Jotasquimsdb/TCC-Caua-e-Joaquim/fotos/ft2.jpeg

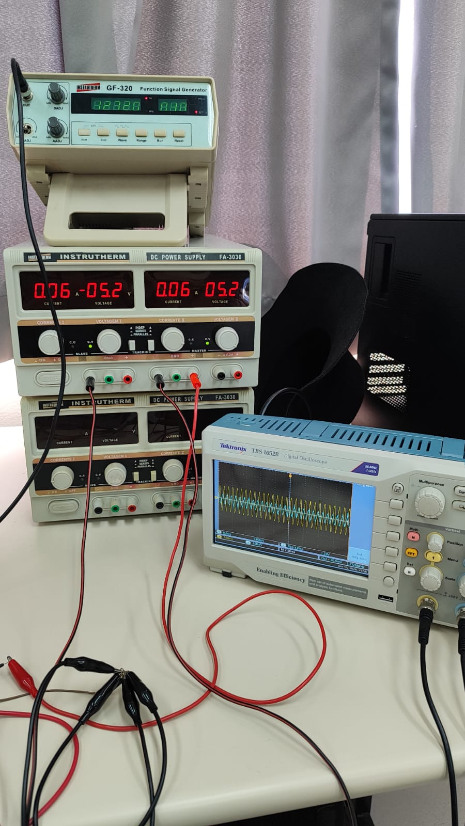
fotos/ft2.jpeg
