Jotasquimsdb/TCC-Caua-e-Joaquim/fotos/ft1.jpeg

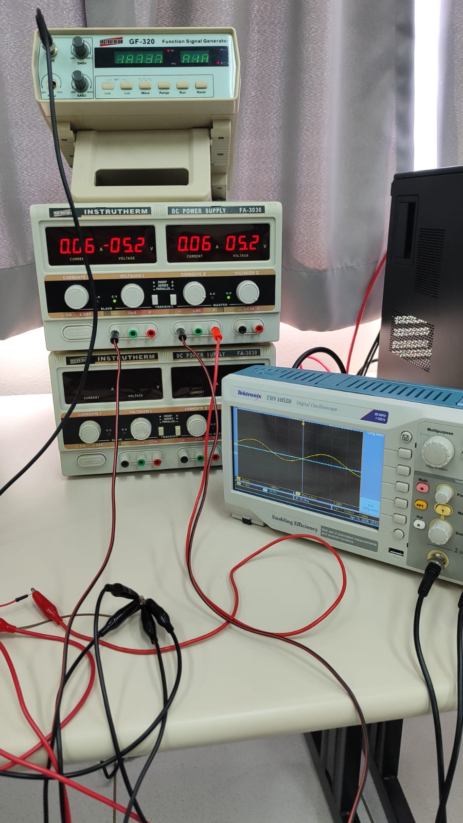
fotos/ft1.jpeg
