Jotasquimsdb/TCC-Caua-e-Joaquim/README.md

# TCC-Caua e Joaquim
 Prótese de mão Robótica Mioelétrica
