Jotasquimsdb/TCC-Caua-e-Joaquim/apresentações e banners/apresentaçãomovaci/Prótese de mão robótica mioelétrica (1).pdf

## Prótese de mão robótica

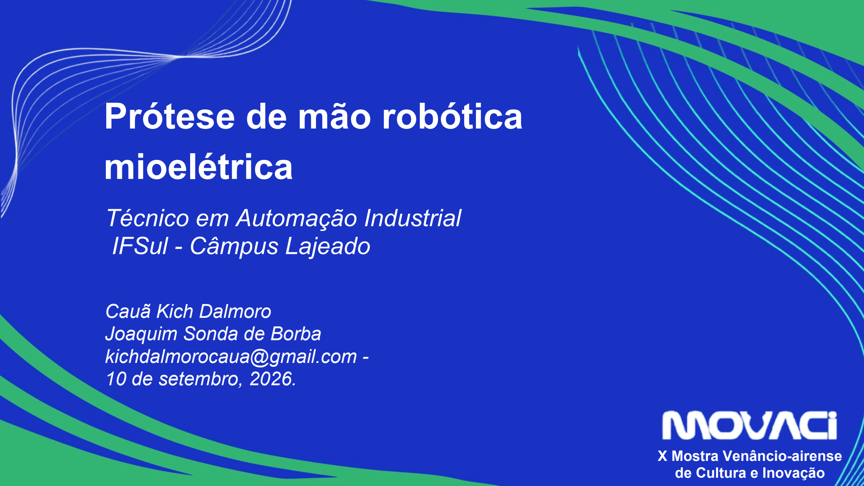
[picture p18: page 1]

## mioelétrica

Técnico em Automação Industrial IFSul - Câmpus Lajeado

Cauã Kich Dalmoro
Joaquim Sonda de Borba
kichdalmorocaua@gmail.com -10 de setembro, 2026.

X Mostra Venâncio-airense
de Cultura e Inovação

## Sumário

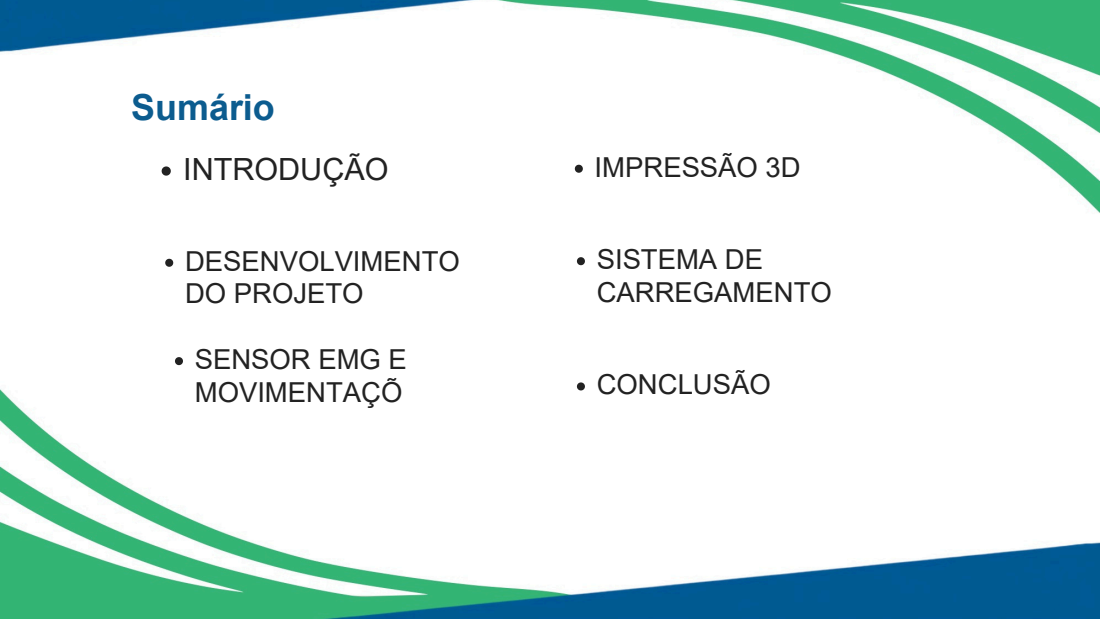
[picture p19: page 2]
DESENVOLVIMENTO DO PROJETO; INTRODUÇÃO; IMPRESSÃO 3D; SENSOR EMG E MOVIMENTAÇÕ; SISTEMA DE CARREGAMENTO; CONCLUSÃO

# INTRODUÇÃO

## Prótese de mão robótica mioelétrica O que são amputações e próteses?

Remoção cirúrgica ou
traumática de um membro ou parte do corpo proveniente de doenças vasculares,
causas traumaticas,tumores ou infecções.

Componente ou dispositivo
artificial criado para substituir uma parte ausente ou
danificada do corpo. Podem ser passivas, mecânicas,
mioelétricas, biônicas ou
recriacionais

## Prótese de mão robótica mioelétrica Justificativa e problema?

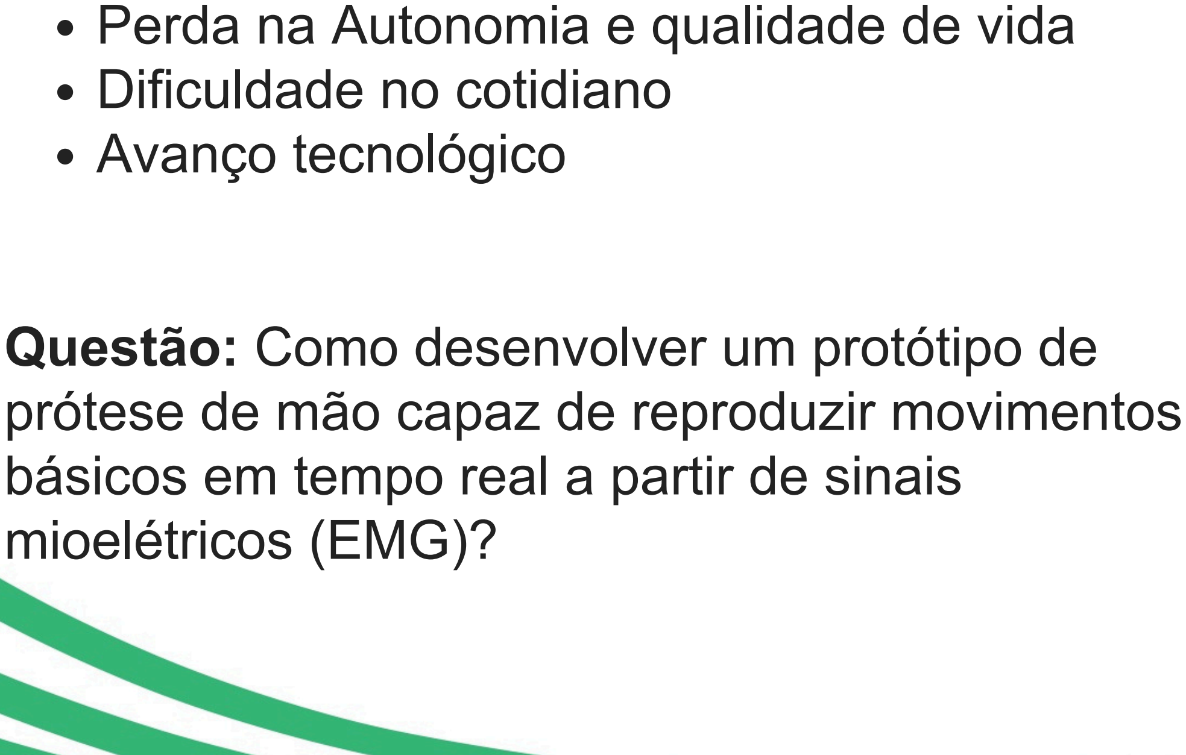
[picture p20: figure]
Perda na Autonomia e qualidade de vida Dificuldade no cotidiano Avanço tecnológico; mioelétricos (EMG)?

Questão: Como desenvolver um protótipo de prótese de mão capaz de reproduzir movimentos básicos em tempo real a partir de sinais

## Prótese de mão robótica mioelétrica Objetivos gerais e específicos

Geral: Desenvolver um protótipo de prótese de mão capaz de

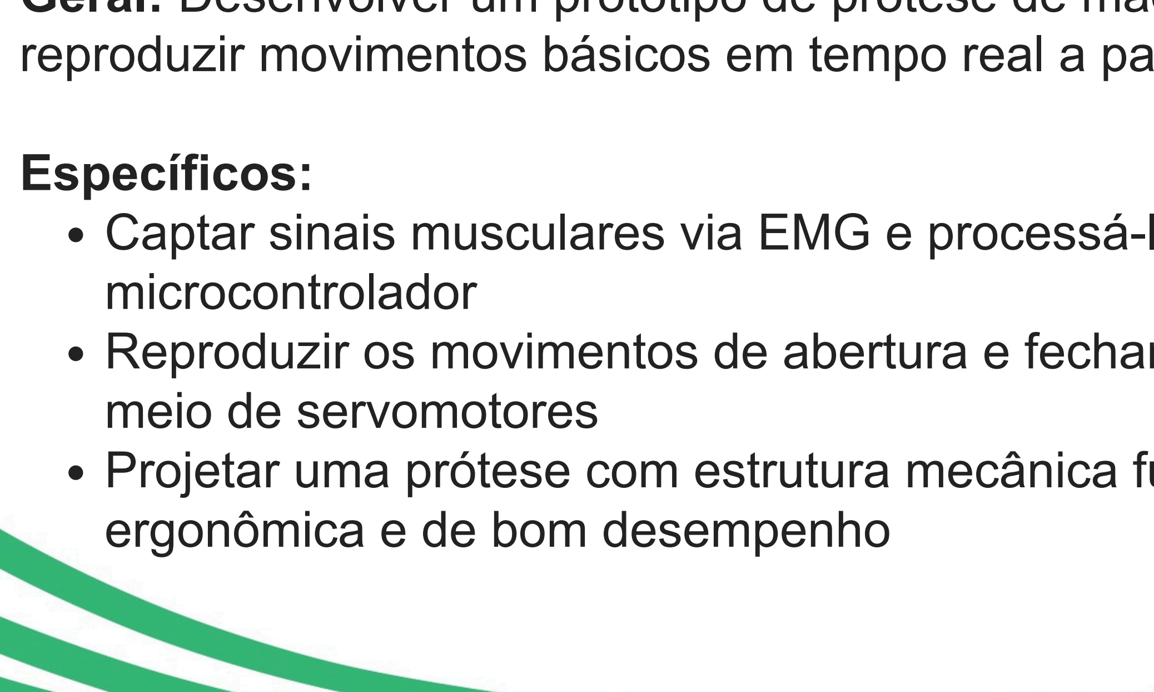
[picture p21: figure]
Específicos:; microcontrolador; meio de servomotores; ergonômica e de bom desempenho

reproduzir movimentos básicos em tempo real a partir de sinais EMG.

Captar sinais musculares via EMG e processá-los no

Reproduzir os movimentos de abertura e fechamento da mão por

Projetar uma prótese com estrutura mecânica funcional,

# DESENVOLVIMENTO DO PROJETO

### Prótese de mão robótica mioelétrica Sinais elétricos musculares

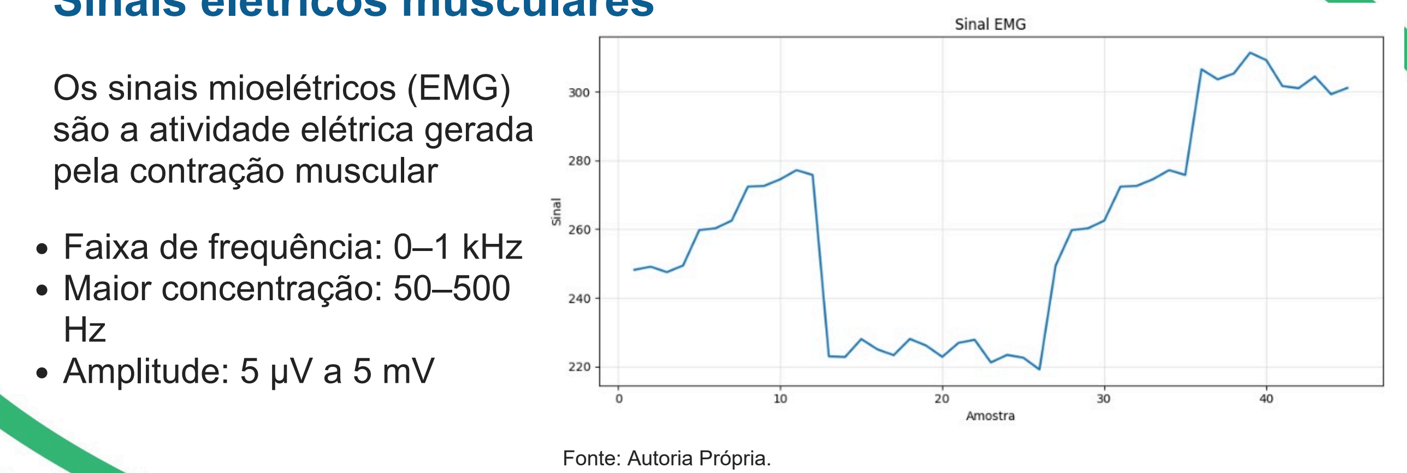
[picture p22: figure]
Os sinais mioelétricos (EMG) são a atividade elétrica gerada pela contração muscular; Fonte: Autoria Própria.; Faixa de frequência: 0–1 kHz Maior concentração: 50–500 Hz Amplitude: 5 µV a 5 mV

## Prótese de mão robótica mioelétrica Sensor invasivo x Sensor não invasivo

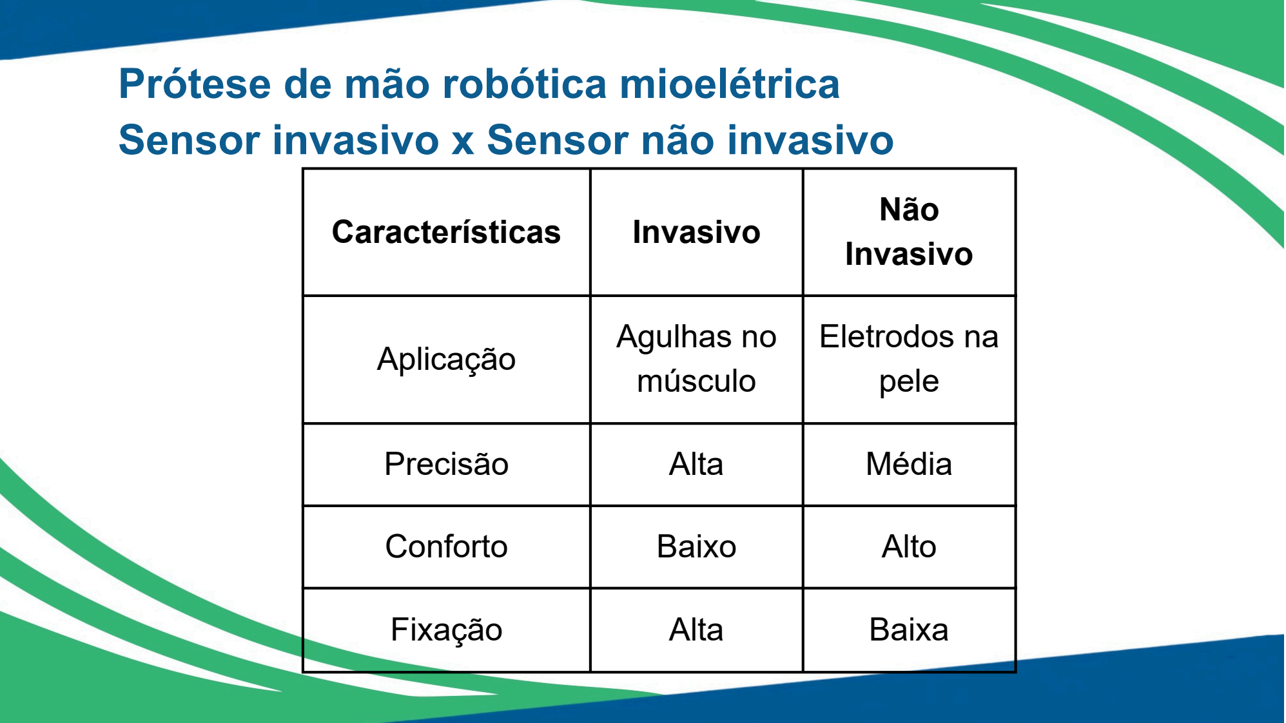
[picture p23: page 9]

Características | Invasivo | Não Invasivo
Aplicação | Agulhas no músculo | Eletrodos na pele
Precisão | Alta | Média
Conforto | Baixo | Alto
Fixação | Alta | Baixa

## Prótese de mão robótica mioelétrica Sensor invasivo x Sensor não invasivo

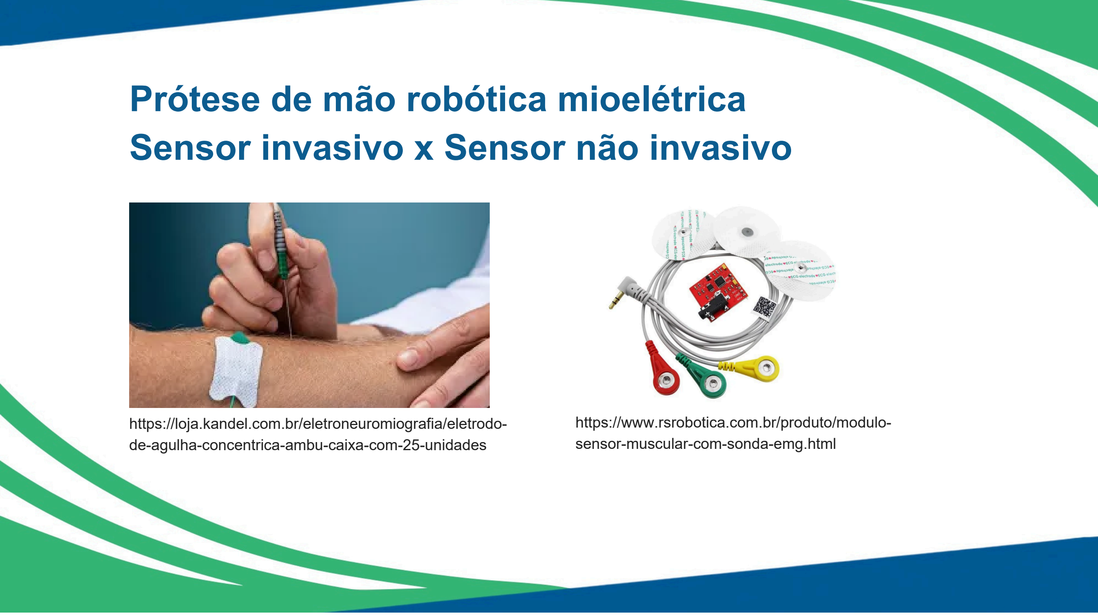
[picture p24: page 10]

https://loja.kandel.com.br/eletroneuromiografia/eletrodode-agulha-concentrica-ambu-caixa-com-25-unidadeshttps://www.rsrobotica.com.br/produto/modulosensor-muscular-c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

# SENSOR EMG E MOVIMENTAÇÃO

## Prótese de mão robótica mioelétrica Funcionamento do sensor Muscle v3

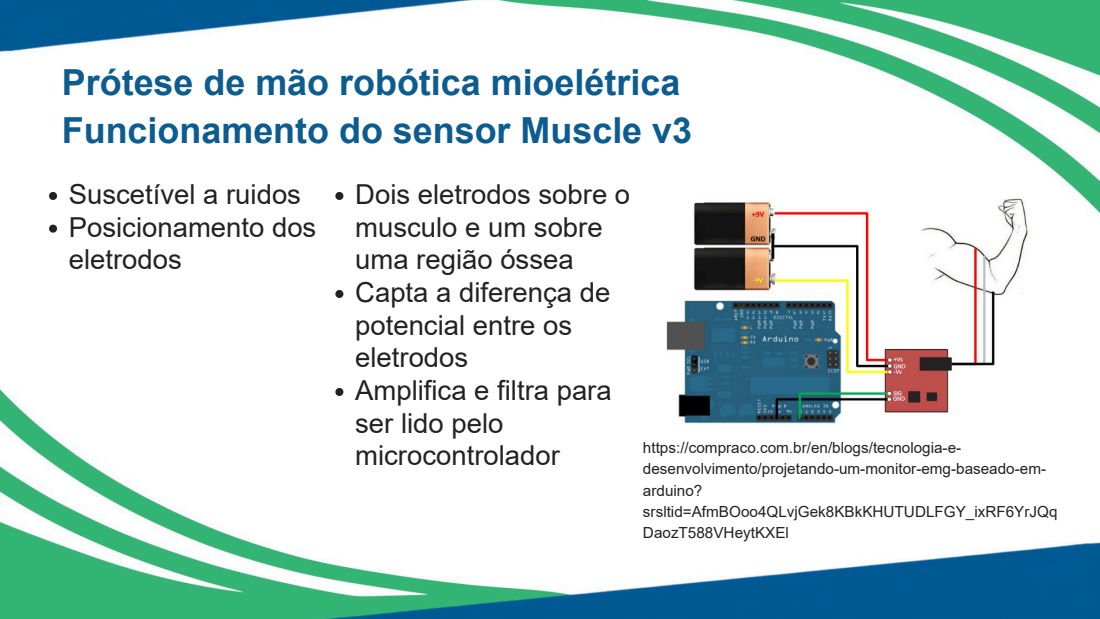
[picture p25: page 12]
microcontrolador; https://compraco.com.br/en/blogs/tecnologia-e-; Suscetível a ruidos Posicionamento dos eletrodos

Dois eletrodos sobre o
musculo e um sobre
uma região óssea
Capta a diferença de
potencial entre os
eletrodos
Amplifica e filtra para
ser lido pelo

desenvolvimento/projetando-um-monitor-emg-baseado-em-
arduino?
srsltid=AfmBOoo4QLvjGek8KBkKHUTUDLFGY_ixRF6YrJQq
DaozT588VHeytKXEl

## Prótese de mão robótica mioelétrica Funcionamento do sensor Muscle v3

Com o objetivo de melhorar a leitura do sensor, foi proposta a seguinte solução:

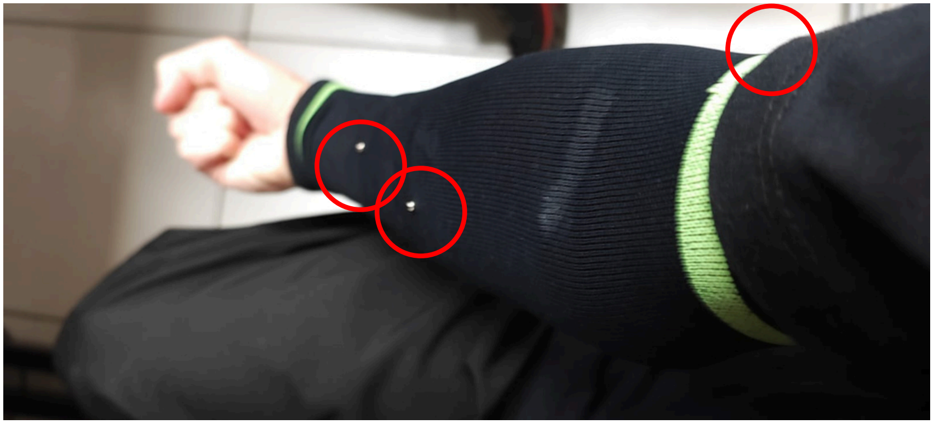
[picture p26: figure]
área para posicionar imagens

Fonte: Autoria Própria

## Prótese de mão robótica mioelétrica Código de leitura do sensor com filtragem

Utilização de uma biblioteca de filtragem
digial

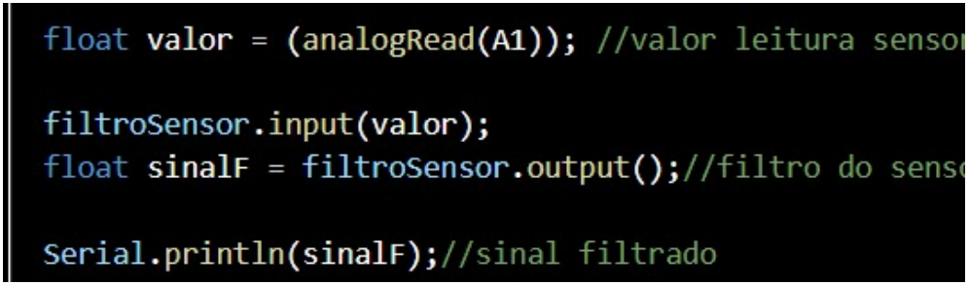
[picture p27: figure]

Fonte: Autoria Própria

Funcionamento:
Leitura do sensor
Aplicação de um filtro passabaixa
Redução de ruídos
Obtenção do sinal filtrado

## Prótese de mão robótica mioelétrica Testes de leitura do sinal

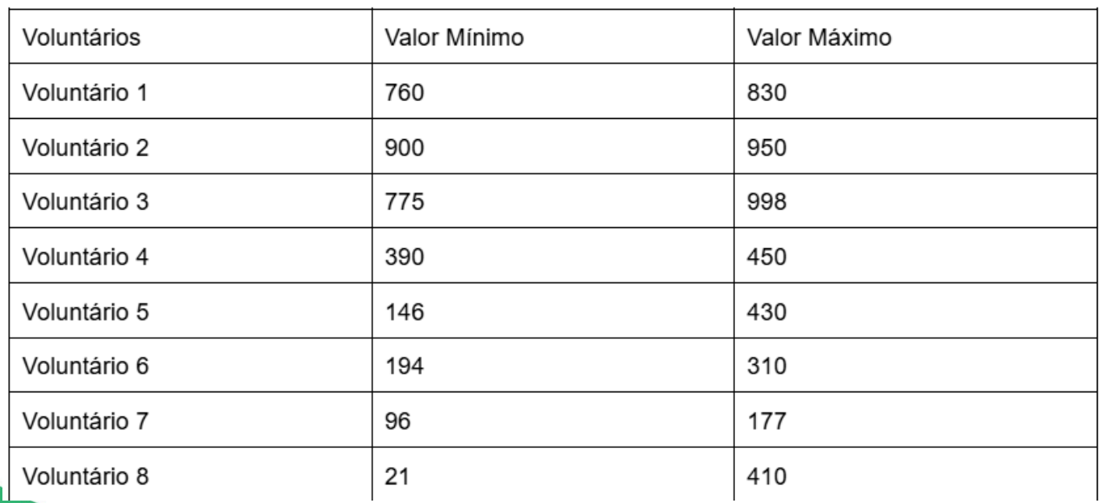
[picture p28: figure]

## Prótese de mão robótica mioelétrica Controle dos servosmotores

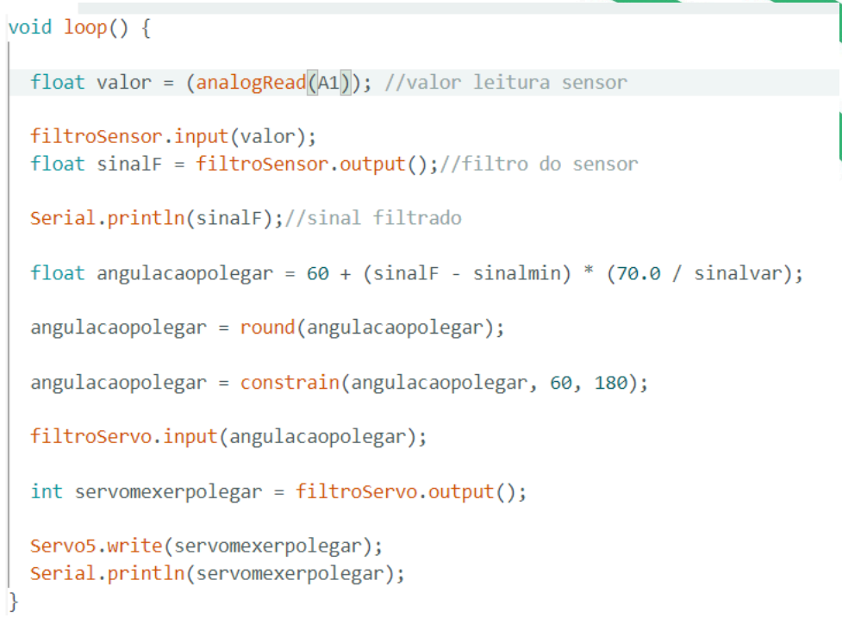
[picture p29: figure]

Fonte: Autoria Própria

Conversão do sinal EMG em
ângulo
Limitação do movimento do
servo pra cada dedo
Acionamento do servomotor
Monitoramento e calibração via Serial Plotter

## Prótese de mão robótica mioelétrica Servomotores

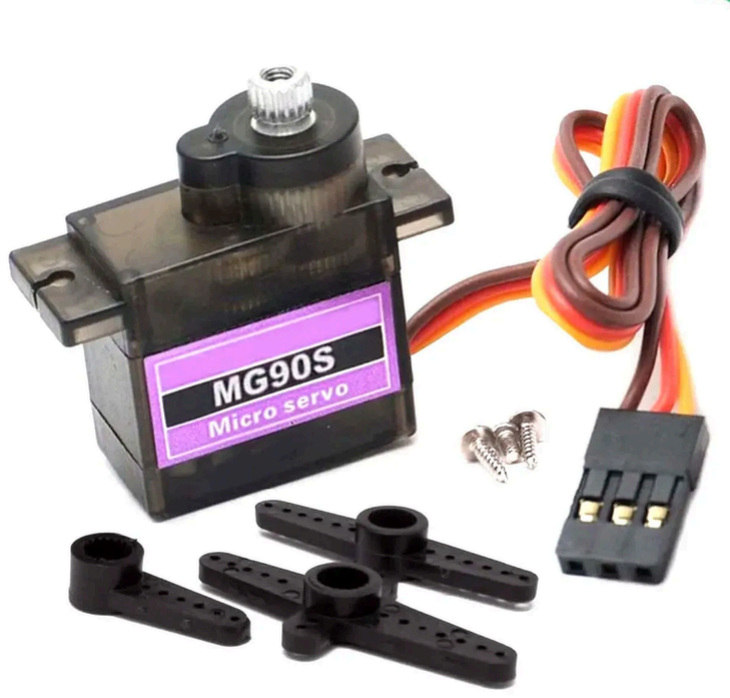
[picture p30: figure]

https://www.casadarobotica.com/robotica/atuadores/servos/microservo-motor-tower-pro-mg90s-metal-gear-com-acessorios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

Características do servomotor MG90S:
Peso: 13,4g
Tensão de operação: 5V
Torque: 1,8 kgfcm (4,8V)
Torque: 2,2 kgfcm (6V)

# IMPRESSÃO 3D

## Prótese de mão robótica mioelétrica Impressão da mão 3D

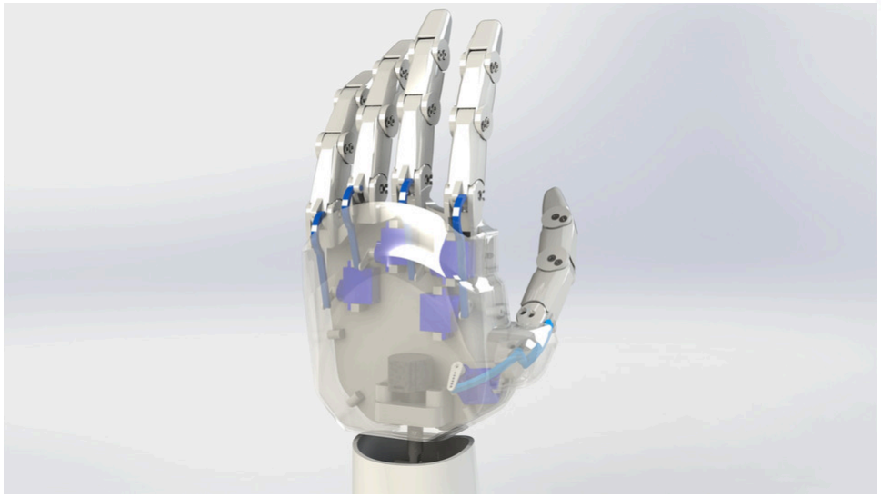
[picture p31: figure]
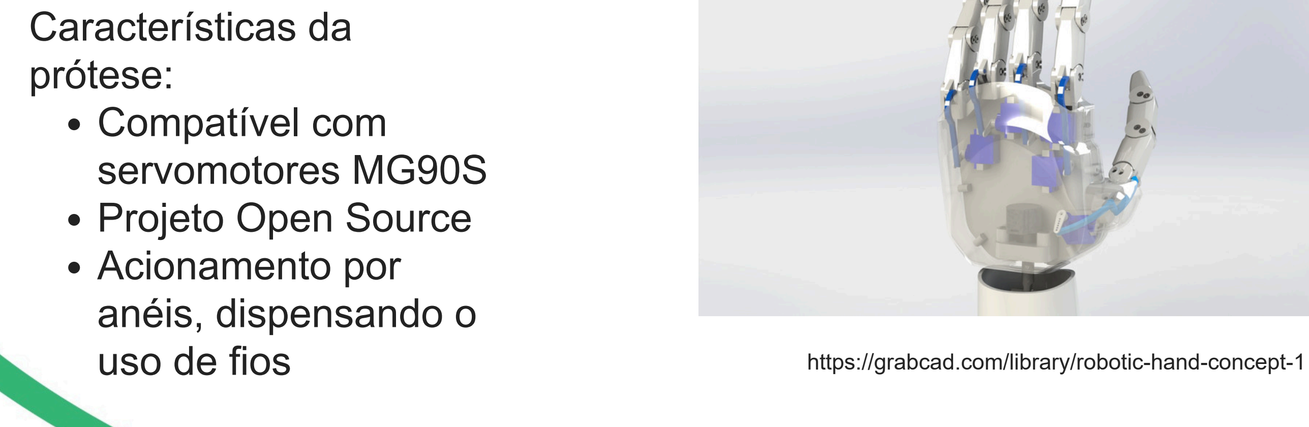
[picture p32: figure]
Características da prótese: Compatível com servomotores MG90S Projeto Open Source Acionamento por anéis, dispensando o; uso de fios; https://grabcad.com/library/robotic-hand-concept-1

## Prótese de mão robótica mioelétrica Impressão da mão 3D

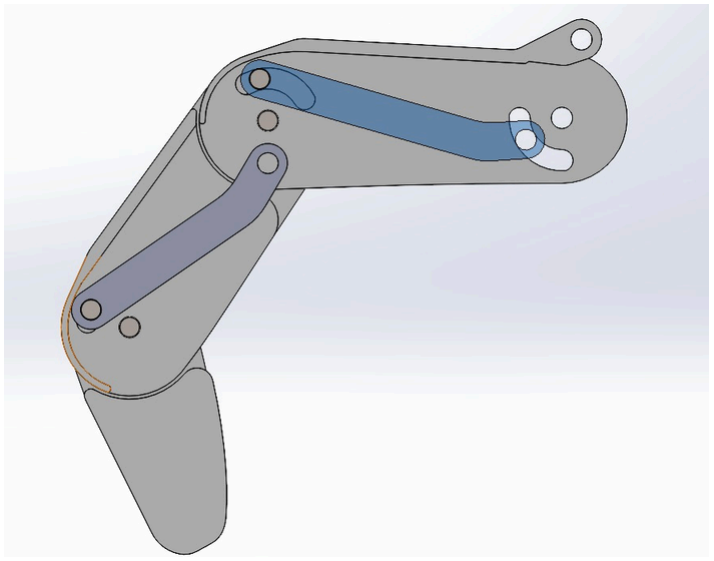
[picture p33: figure]
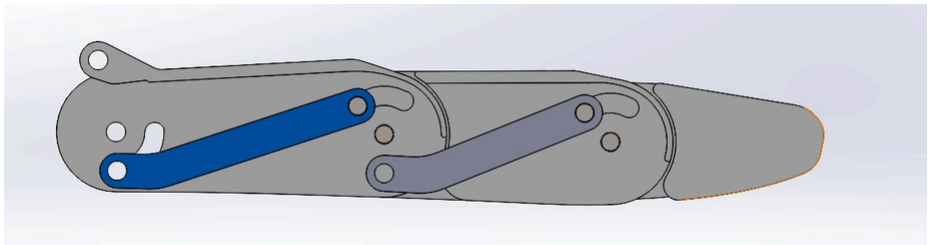
[picture p34: figure]

Fonte: Imagens pelos autores via software SolidWorks

## Prótese de mão robótica mioelétrica Impressão da mão 3D

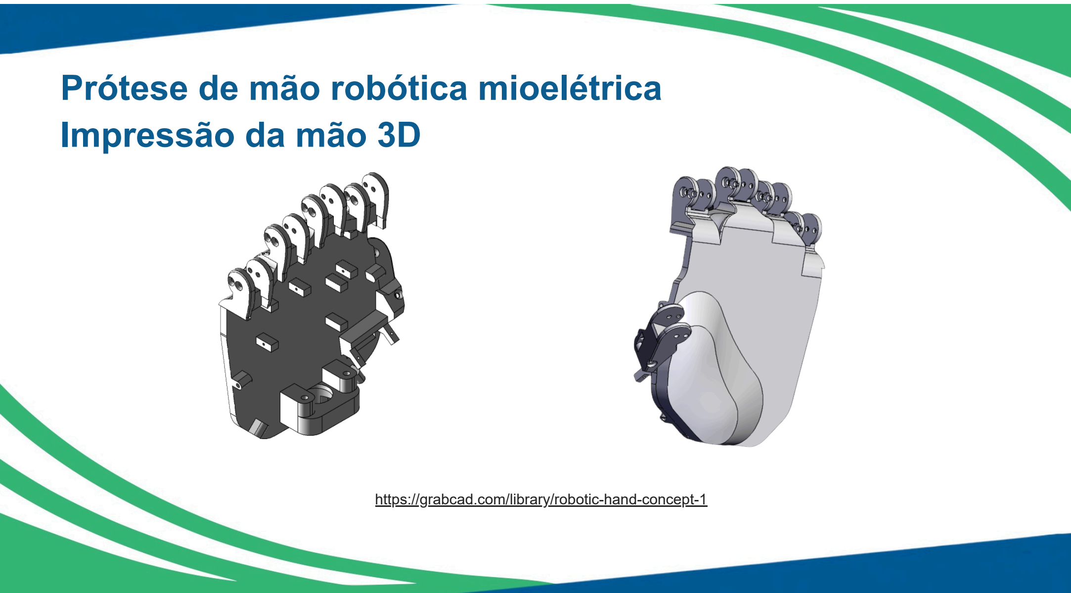
[picture p35: page 21]

https://grabcad.com/library/robotic-hand-concept-1

# SISTEMA DE CARREGAMENTO

## Prótese de mão robótica mioelétrica

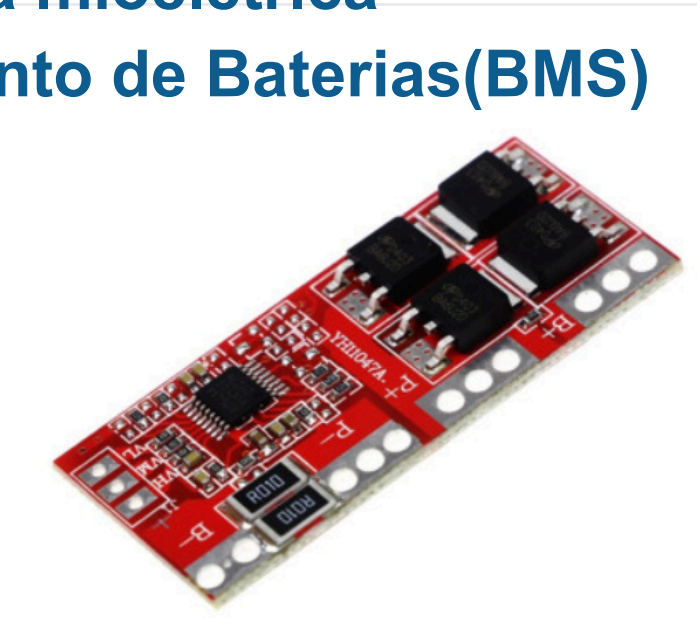
[picture p36: figure]

## Sistema de Gerenciamento de Baterias(BMS)

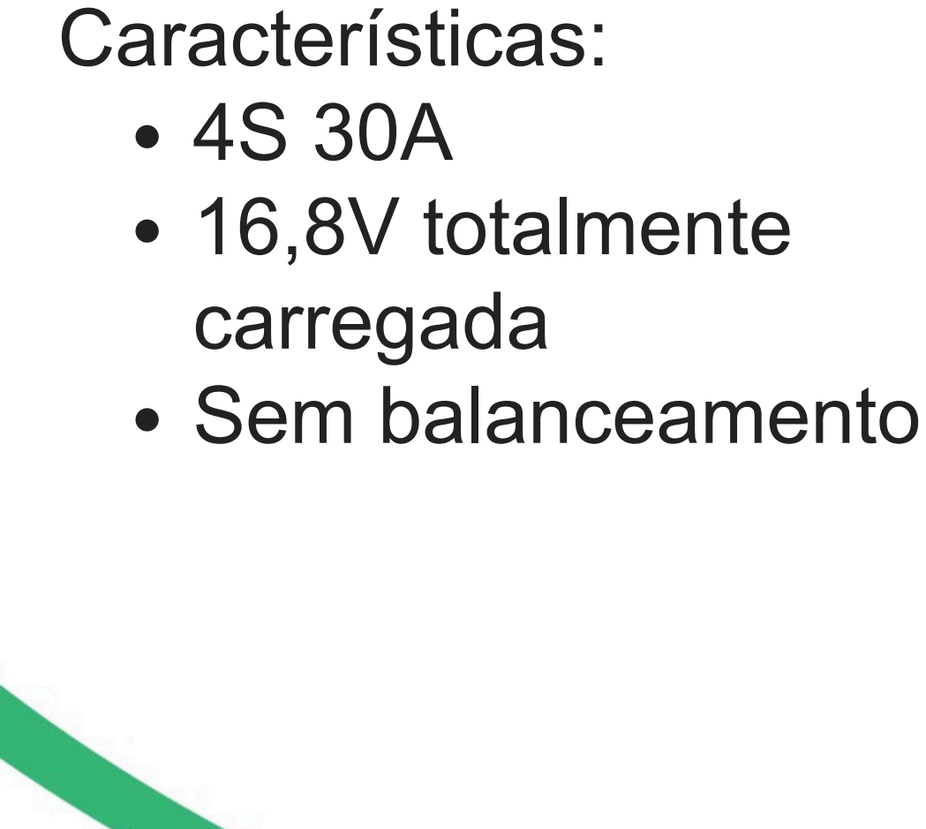
[picture p37: figure]
Características: 4S 30A 16,8V totalmente carregada Sem balanceamento

https://sigmanortec.ro/en/bms-module-4s-30a-148v

## Prótese de mão robótica mioelétrica Sistema de Gerenciamento de Baterias(BMS)

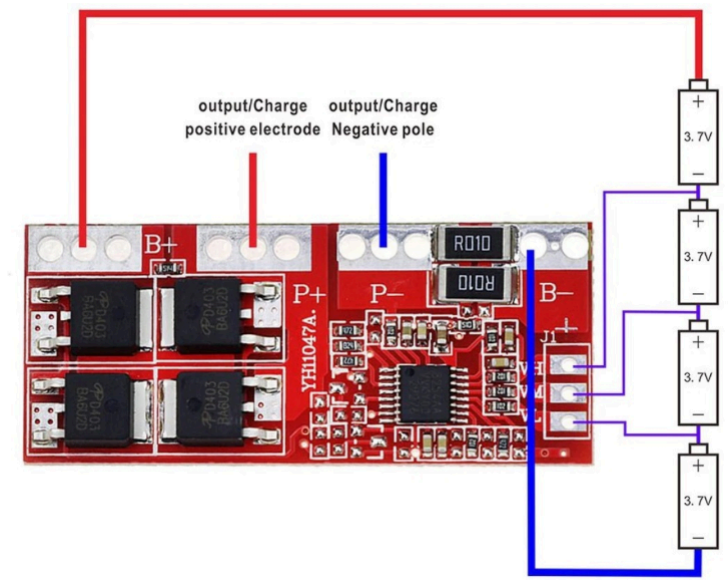
[picture p38: figure]

https://sigmanortec.ro/en/bms-module-4s-30a-148v

## Prótese de mão robótica mioelétrica Carregamento das células

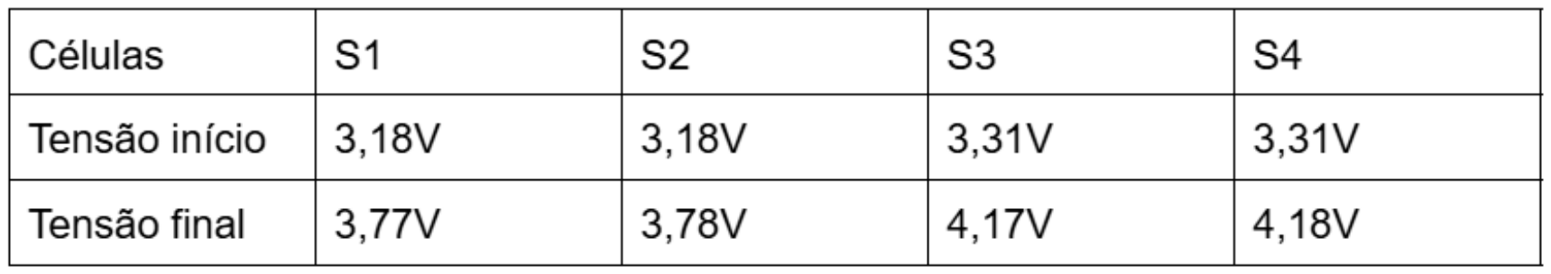
[picture p39: figure]

## Prótese de mão robótica mioelétrica Descarregamento das células

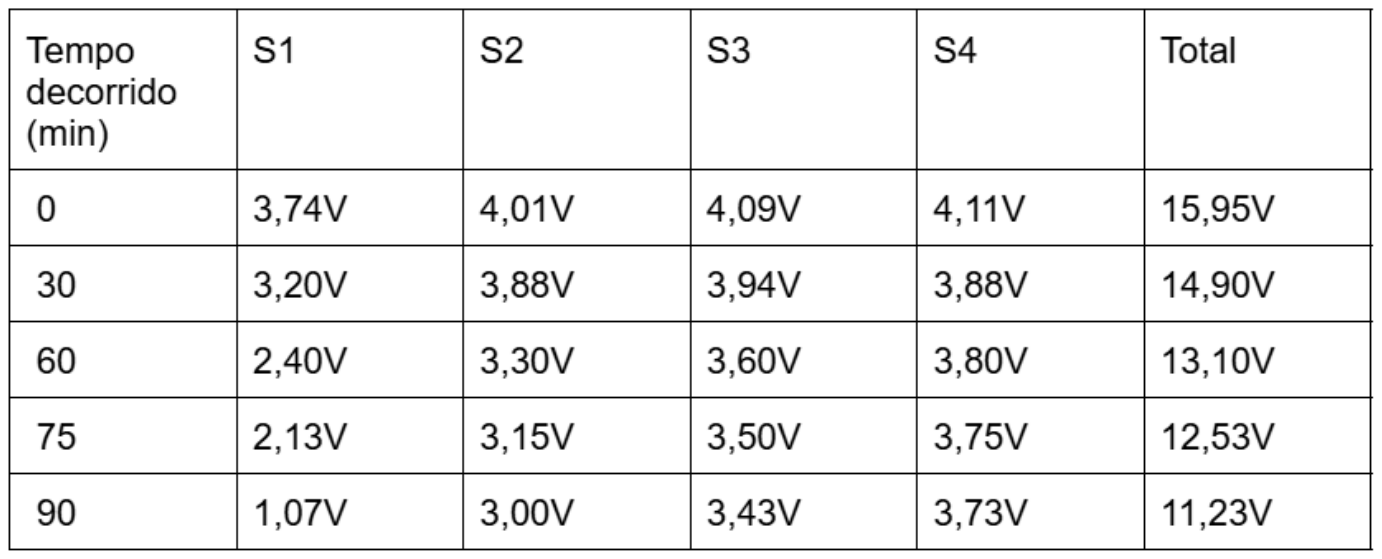
[picture p40: figure]

# CONCLUSÃO

## Prótese de mão robótica mioelétrica Conclusão

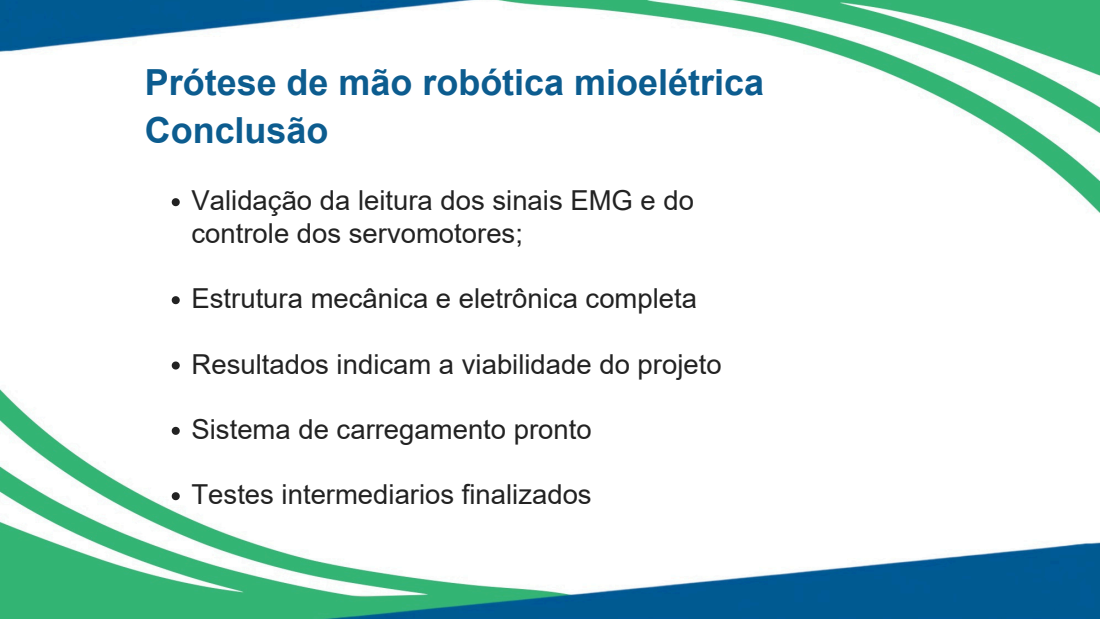
[picture p41: page 28]

Validação da leitura dos sinais EMG e do
controle dos servomotores;

Estrutura mecânica e eletrônica completa

Resultados indicam a viabilidade do projeto

Sistema de carregamento pronto

Testes intermediarios finalizados

## Prótese de mão robótica mioelétrica Próximos passos

Integrar os sistemas eletrônico e mecânico,

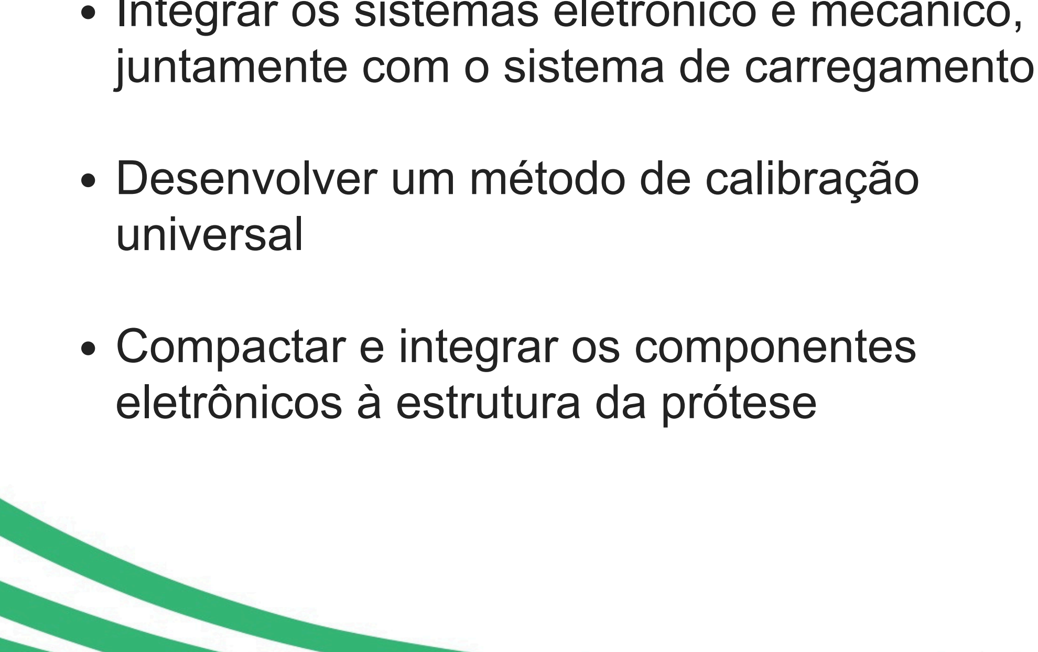
[picture p42: figure]
Desenvolver um método de calibração universal; Compactar e integrar os componentes eletrônicos à estrutura da prótese

juntamente com o sistema de carregamento

## Referências

MORENO, Ana Luiza Tupam Miguel. Estudo e desenvolvimento de uma prótese de mão mioelétrica. 2021.https://repositorio.ufsm.br/handle/1/22127
GOMES, Guilherme Gallo Costa et al. Construção de uma prótese mioelétrica de mão controlada por micromotores conectados a uma placa de Arduino. Brazilian Journal of Health Review, 2019.https://ojs.brazilianjournals.com.br/ojs/index.php/BJHR/article/view/860/1076
CAPARELLI, Thiago Bruno. Projeto e desenvolvimento de um sistema multicanal de biotelemetria para detecção de sinais ECG, EEG e EMG. 2007.https://repositorio.ufu.br/handle/123456789/14636 MISSIO, A. L.; QUEIROZ, M. E. C. Tecnologia assistiva: aspectos que influenciam na assiduidade e no abandono dos recursos. Acta Fisiátrica, 2018.https://revistas.usp.br/actafisiatrica/article/view/163858/159150
IBGE. Pesquisa Nacional de Saúde 2019 – Tabela 8232.https://sidra.ibge.gov.br/tabela/8232 ADVANCING TECHNOLOGIES. Muscle Sensor v3 – User's Manual. 2022.https://www.datasheethub.com/wp-content/uploads/2022/10/Muscle-Sensor-v3-Users-Manual.pdf TOWER PRO. SG90.
Datasheet.http://www.ee.ic.ac.uk/pcheung/teaching/DE1_EE/stores/sg90_datasheet.pdf
TOWER PRO. MG90S.https://www.electronicoscaldas.com/datasheet/MG90S_Tower-Pro.pdf

# Obrigado pela

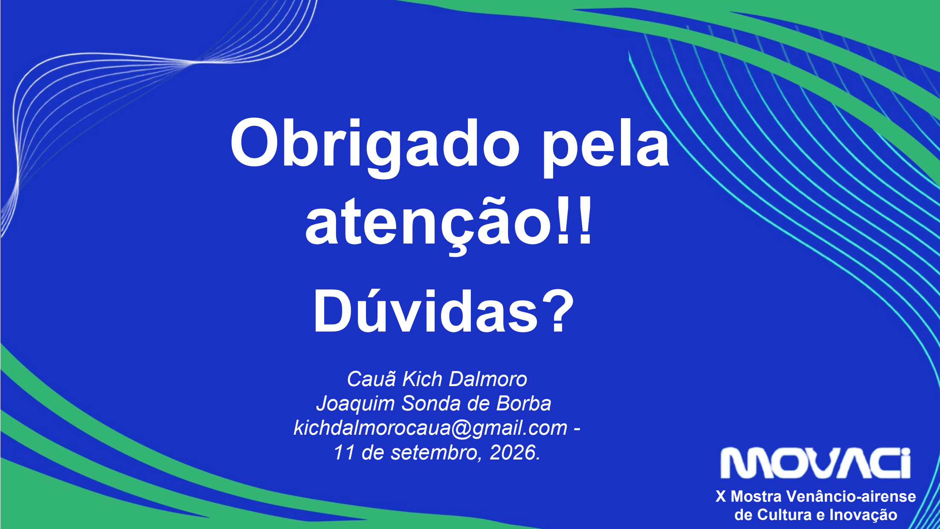
[picture p43: page 31]

# atenção!!

X Mostra Venâncio-airense
de Cultura e Inovação

# Dúvidas?

Cauã Kich Dalmoro
Joaquim Sonda de Borba
kichdalmorocaua@gmail.com -11 de setembro, 2026.
