Jotasquimsdb/TCC-Caua-e-Joaquim/gestão e empreendedorismo empresa ficticia/Joaquim Sonda de Borba relatório de entrevisatas de tcc (1).pdf

4º AUTIN manhã
Aluno : Joaquim Sonda de Borba

Empresa 1
Nome fantasia ou razão social da empresa: Caliari esquadrias LTDA CNPJ informado : 31433464000115
Número de funcionários: 3

Empresa 2
Nome fantasia ou razão social da empresa: Malvi Indústria e Comércio de Alimentos CNPJ informado :
44727251000148
Número de funcionários: 30

RELATÓRIO DE ENTREVISTAS COM ESPECIALISTAS

Com o objetivo de complementar a pesquisa realizada com o público-alvo e obter uma visão externa sobre a proposta, foram realizadas entrevistas com representantes de duas empresas da região: Caliari Esquadrias LTDA e Malvi Indústria e Comércio de Alimentos.
As empresas foram escolhidas por representarem diferentes setores produtivos da região, permitindo uma avaliação externa sobre a relevância social, o potencial de aplicação e os desafios envolvidos no desenvolvimento da solução.
As entrevistas foram conduzidas utilizando as seguintes perguntas:
1. Na sua percepção, o problema apresentado realmente existe? Se sim, como este problema impacta a sociedade?
2. A proposta apresentada parece capaz de resolver ou reduzir este problema? Por quê?
3. O que você considera mais interessante ou valioso nesta proposta?
4. Quais as principais fragilidades, riscos ou melhorias que você enxerga na proposta?
5. Se esta solução estivesse disponível hoje, qual seria sua disposição para utilizá-la ou contratá-la? Justifique sua resposta.
6. Quanto você acredita que empresas ou pessoas estariam dispostas a investir nesta solução?

Instituto Federal de Educação, Ciência e Tecnologia Sul-rio-grandense – Campus Lajeado Curso Téc. de Nível Médio Integrado em Automação Industrial Disciplina: Gestão e Empreendedorismo Professor: Péricles Thiele Purper

Análise Comparativa das Entrevistas

As duas empresas entrevistadas concordaram que o problema abordado pelo projeto é real e afeta significativamente a vida das pessoas que possuem amputações ou malformações nos membros superiores.
Entretanto, cada entrevistado destacou impactos diferentes. O representante da Caliari Esquadrias enfatizou principalmente a perda de autonomia, autoestima e dignidade causada pela limitação física. Segundo ele, "recuperar a independência do dia a dia traz de volta a dignidade da pessoa".
Já o representante da Malvi Indústria e Comércio de Alimentos destacou os impactos na vida profissional e emocional dos indivíduos, ressaltando que a deficiência pode dificultar a participação no mercado de trabalho e limitar a realização de atividades cotidianas.
Quando questionados sobre a capacidade da solução em resolver o problema, ambos demonstraram confiança na proposta. A Caliari destacou que a tecnologia possui potencial para ir além da simples redução das dificuldades, podendo devolver grande parte da autonomia perdida. Já a Malvi ressaltou que, caso a solução funcione conforme esperado, poderá proporcionar maior independência e permitir que o usuário retome suas atividades diárias.
Em relação ao principal valor da proposta, houve forte convergência entre os entrevistados. Ambos apontaram a recuperação da autonomia como o principal benefício da solução. A Caliari também destacou a inclusão social e a possibilidade de reinserção do indivíduo em sua rotina, enquanto a Malvi enfatizou a capacidade da tecnologia de devolver qualidade de vida e participação ativa na sociedade.
As fragilidades apontadas apresentaram diferenças importantes. A Caliari demonstrou preocupação com a continuidade do projeto após sua fase acadêmica, destacando o risco de uma boa ideia não chegar efetivamente à sociedade. Além disso, sugeriu a busca por parcerias com empresas e instituições capazes de produzir a solução em escala.
Por outro lado, a Malvi concentrou suas observações em aspectos técnicos, como durabilidade dos componentes, custos de manutenção e confiabilidade do equipamento durante o uso cotidiano. Também sugeriu melhorias relacionadas à movimentação do punho e à capacidade da prótese de manipular objetos com maior precisão.

Sul-rio-grandense – Campus Lajeado Curso Téc. de Nível Médio Integrado em Automação Industrial Disciplina: Gestão e Empreendedorismo Professor: Péricles Thiele Purper

Sobre a disposição para utilizar a solução, ambos afirmaram que a utilizariam caso existisse necessidade, desde que o produto apresentasse eficiência, conforto e suporte adequado ao usuário.
Quanto ao potencial de investimento, as respostas apresentaram perspectivas diferentes. A Caliari acredita que os principais interessados serão pessoas diretamente afetadas pela deficiência e seus familiares. Já a Malvi considera que tanto indivíduos quanto organizações poderão investir na tecnologia, desde que ela demonstre resultados concretos e benefícios comprovados.

Tabela Comparativa

Aspecto | Caliari Esquadrias | Malvi Indústria e Comércio de Alimentos
O problema existe? | Sim | Sim
Principal impacto identificado | Perda de autonomia, autoestima e dignidade | Limitação profissional e impacto emocional
Capacidade da solução | Pode devolver grande parte da autonomia | Pode trazer maior independência ao usuário
Principal benefício | Inclusão social e retorno à rotina | Retorno às atividades e qualidade de vida
Fragilidade apontada | Continuidade do projeto após a fase escolar | Durabilidade e manutenção
Melhorias sugeridas | Parcerias e produção em escala | Movimentação do punho e precisão
Disposição para utilizar | Sim, em caso de necessidade | Sim, em caso de necessidade
Potencial de investimento | Pessoas afetadas e familiares | Pessoas e organizações interessadas

Validações Obtidas

Sul-rio-grandense – Campus Lajeado Curso Téc. de Nível Médio Integrado em Automação Industrial Disciplina: Gestão e Empreendedorismo Professor: Péricles Thiele Purper

As entrevistas permitiram validar os seguintes pontos:
- O problema identificado é real e possui relevância social.
- Pessoas com amputações ou malformações enfrentam limitações que afetam sua autonomia e qualidade de vida.
- Existe interesse em soluções capazes de devolver independência ao usuário.
- Funcionalidade, conforto e praticidade são fatores fundamentais para a aceitação da tecnologia.
- A proposta apresenta potencial para gerar impacto social positivo e promover inclusão.

Hipóteses que Ainda Precisam Ser Validadas

Apesar dos resultados positivos, algumas questões ainda precisam ser investigadas:
- Durabilidade da prótese durante o uso contínuo.
- Custos de manutenção ao longo do tempo.
- Adaptação da solução a diferentes perfis de usuários.
- Viabilidade de produção em maior escala.
- Modelo de distribuição e acesso à tecnologia.
- Nível de aceitação após testes práticos com usuários reais.

Conclusão

As entrevistas realizadas contribuíram significativamente para a validação do problema e da proposta de solução. Os resultados demonstram que a recuperação da autonomia é percebida como o principal benefício da tecnologia e que existe potencial para gerar impacto social relevante.
Além de confirmar a importância do problema, as entrevistas também forneceram direcionamentos importantes para as próximas etapas do projeto, permitindo identificar melhorias, riscos e hipóteses que deverão ser avaliadas durante o desenvolvimento e aperfeiçoamento da prótese.

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
