Jotasquimsdb/TCC-Caua-e-Joaquim/gestão e empreendedorismo empresa ficticia/bmc antes tcc.pdf

8.Parceiros chave | 7.Atividades chave

### 6.Recursos chave

2.Proposta de valor | 4.Relacionamento com o cliente

### 3.Canais

### 1.Segmento de Mercado

### 9.Estrutura de custos

### 5.Fontes de renda

# Prótese de mão robótica

- Instituições de ensino - Hospitais -Associações de amputados - Profissionais da saúde - Comunidade maker - Empresas de tecnologia assistiva
- Desenvolvimento do protótipo -Programação - Captação de sinais musculares - Testes - Pesquisa com usuários
- Ajustes ergonômicos
- Conhecimento técnico em automação -Arduino e microcontroladores - Sensores EMG - Impressão 3D - Pesquisa de mercado
- Protótipo funcional

Dependências críticas - Componentes eletrônicos - Validação com usuários reais -Orientação técnica

Problema resolvido - Dificuldade em realizar tarefas básicas do cotidiano devido à ausência parcial da mão.

Ganhos entregues - Recuperação parcial da autonomia - Maior independência -Facilidade em tarefas diárias - Inclusão social - Melhora na autoestima

Diferencial - Controle por sinais musculares
- Solução confortável e funcional -Desenvolvimento baseado em pesquisa real com usuários - Foco em praticidade no cotidiano
- Atendimento próximo e humanizado -Coleta constante de feedback - Ajustes conforme necessidade do usuário -Acompanhamento durante adaptação

Como o cliente conhecerá - Hospitais e clínicas - Associações de amputados

Comunicação - Instagram - WhatsApp -Demonstrações presenciais - Vídeos do protótipo

Clientes principais - Pessoas com amputação parcial da mão - Pessoas com malformações congênitas nos membros superiores

Usuários - Jovens e adultos que necessitam recuperar movimentos básicos da mão

Quem pode pagar - Usuário final -Familiares - Instituições de saúde - ONGs e associações - Futuramente SUS e planos de saúde

Nicho prioritário - Jovens e adultos com amputação parcial da mão e dificuldade em atividades do cotidiano

Custos fixos - Ferramentas - Equipamentos - Software

Custos variáveis - Sensores EMG - Servomotores - Impressão 3D - Filamentos - Baterias - Componentes eletrônicos

Custos invisíveis - Tempo de desenvolvimento - Manutenção - Ajustes ergonômicos - Testes - Transporte - Substituição de peças

Possíveis receitas - Venda da prótese - Manutenção e suporte - Parcerias institucionais - Projetos financiados - Editais de inovação
