Jotasquimsdb/TCC-Caua-e-Joaquim/3d/moãinteira/Cattura0.PNG

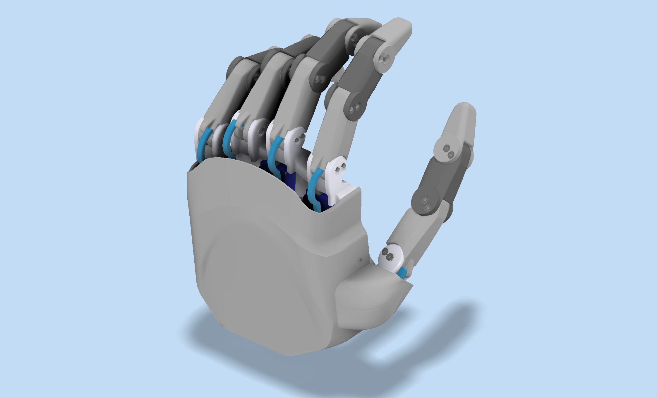
3d/moãinteira/Cattura0.PNG
