Jotasquimsdb/TCC-Caua-e-Joaquim/3d/moãinteira/Cattura1.PNG

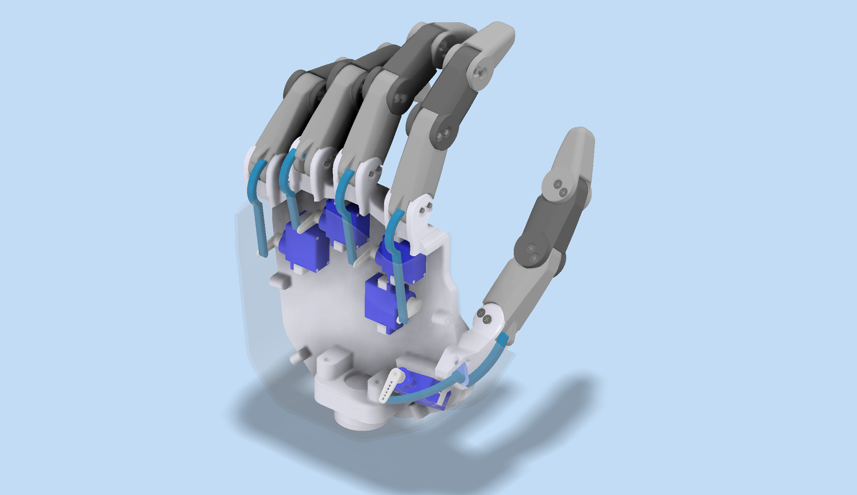
3d/moãinteira/Cattura1.PNG
