Jotasquimsdb/TCC-Caua-e-Joaquim/3d/moãinteira/Cattura3.PNG

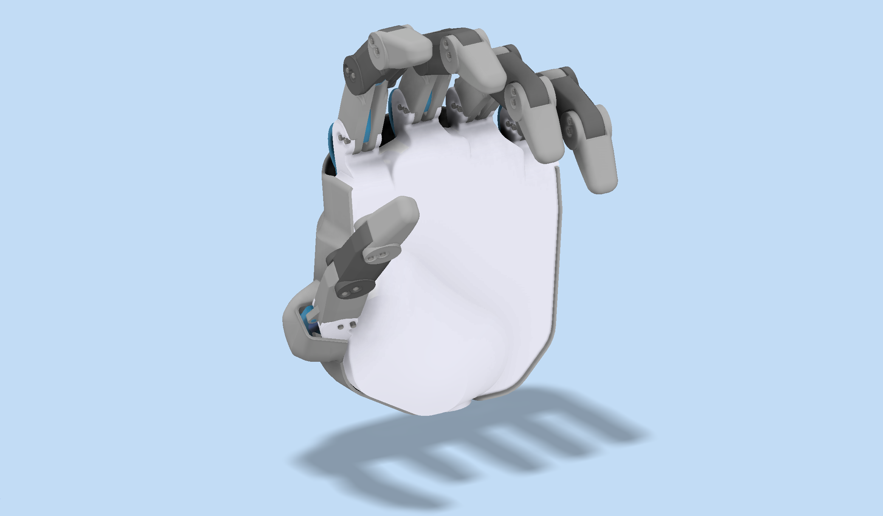
3d/moãinteira/Cattura3.PNG
