Jotasquimsdb/TCC-Caua-e-Joaquim/3d/moãinteira/Cattura4.PNG

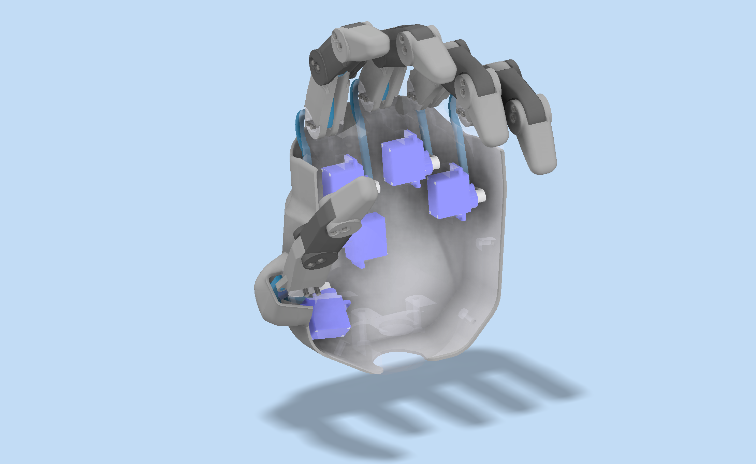
3d/moãinteira/Cattura4.PNG
