Jotasquimsdb/TCC-Caua-e-Joaquim/3d/moãinteira/Cattura5.PNG

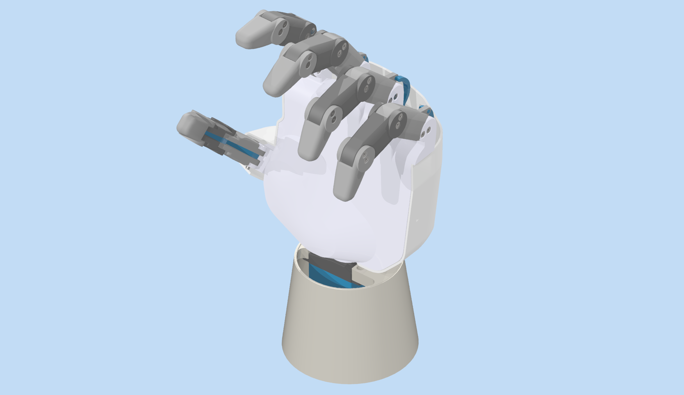
3d/moãinteira/Cattura5.PNG
