Jotasquimsdb/TCC-Caua-e-Joaquim/3d/Nova pasta/robotic-hand/Untitled1.JPG

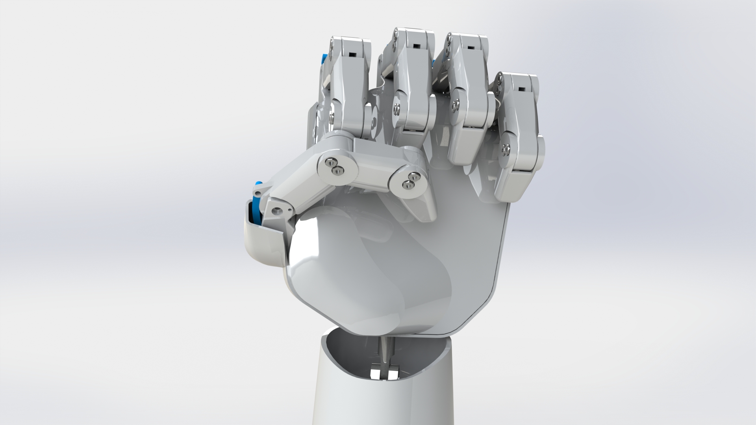
3d/Nova pasta/robotic-hand/Untitled1.JPG
