Jotasquimsdb/TCC-Caua-e-Joaquim/3d/Nova pasta/robotic-hand/Untitled.JPG

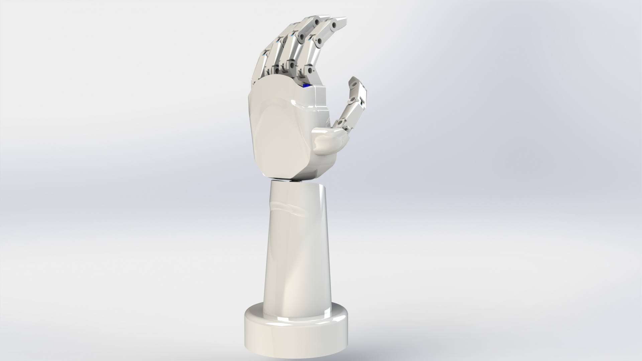
3d/Nova pasta/robotic-hand/Untitled.JPG
