Jotasquimsdb/TCC-Caua-e-Joaquim/fontes/Laboratório da Ufes desenvolve prótese de mão robótica de baixo custo _ Universidade Federal do Espírito Santo_files/mao-robotica.jpeg

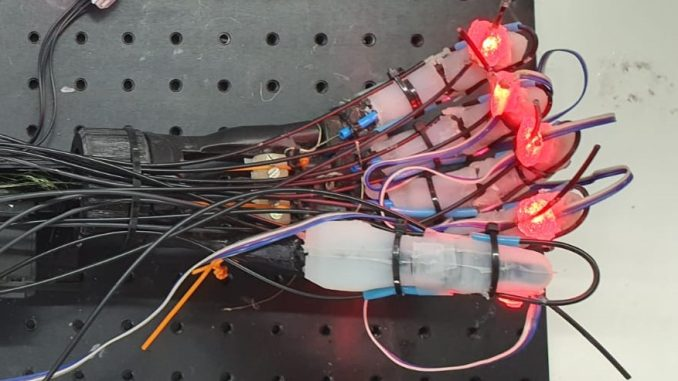
fontes/Laboratório da Ufes desenvolve prótese de mão robótica de baixo custo _ Universidade Federal do Espírito Santo_files/mao-robotica.jpeg
