Jotasquimsdb/TCC-Caua-e-Joaquim/fotos/ft3.jpeg

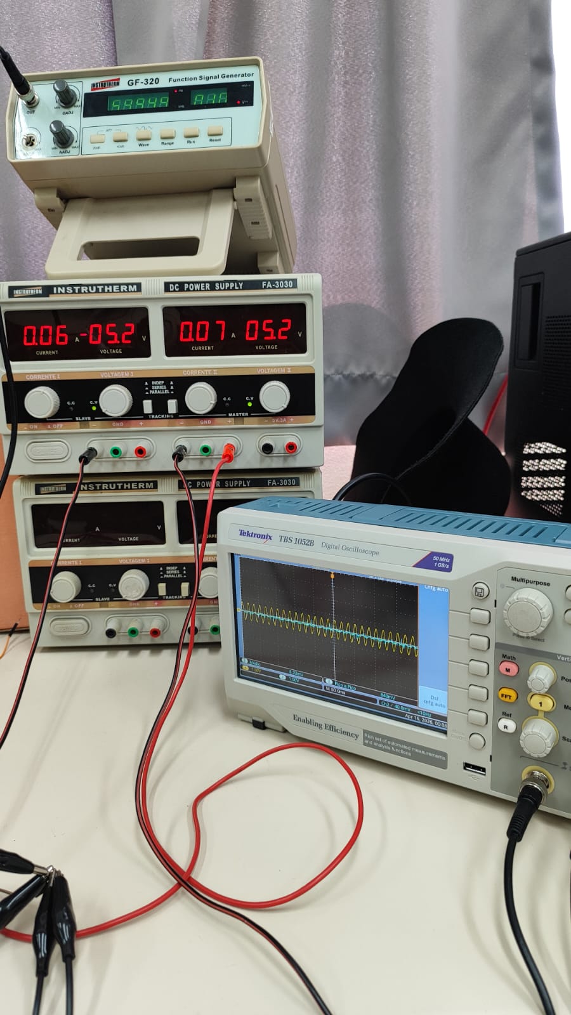
fotos/ft3.jpeg
