Jotasquimsdb/TCC-Caua-e-Joaquim/3d/Nova pasta/robotic-hand/Finger 3/Finger Assembly 3.SLDASM

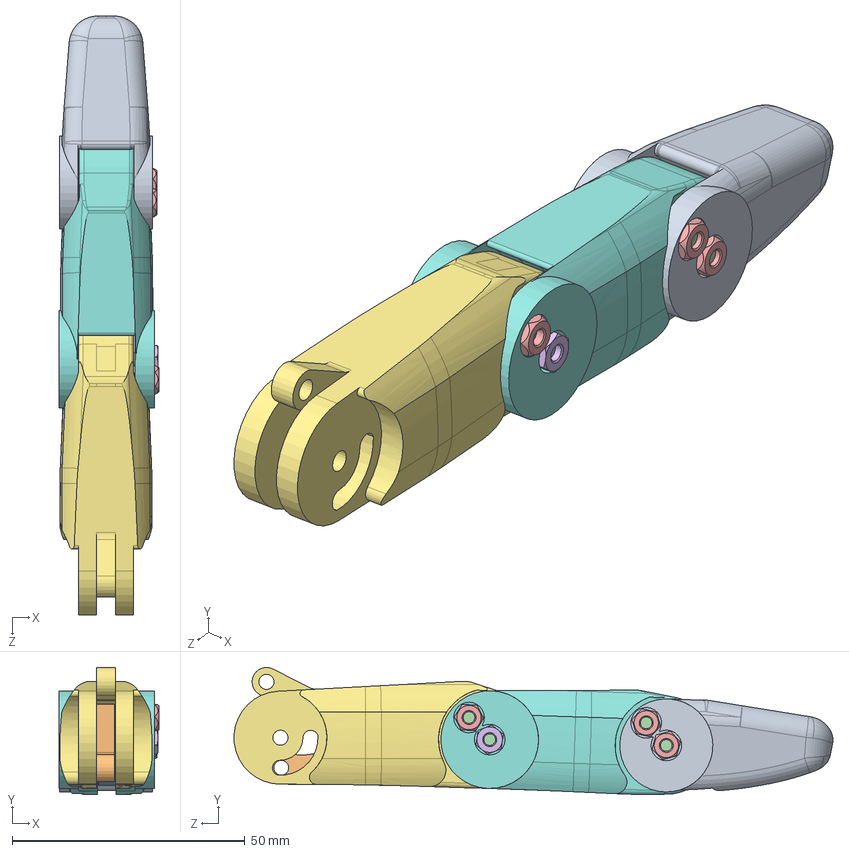
[picture p69: CAD file, 2026-10-15]
3d/Nova pasta/robotic-hand/Finger 3/Finger Assembly 3.SLDASM
21.5 x 27.3 x 128.8 mm
Finger tip
Connection Long test
Connection Short
flat head screw_am x 4
prevailing torque hex nut_am x 3
hex nut style 2_am
Finger segment 1 TESTING FR
Finger segment 2 TESTING FR
