Jotasquimsdb/TCC-Caua-e-Joaquim/3d/moãinteira/PROTO ASSEMBLY FINAL 2.stp

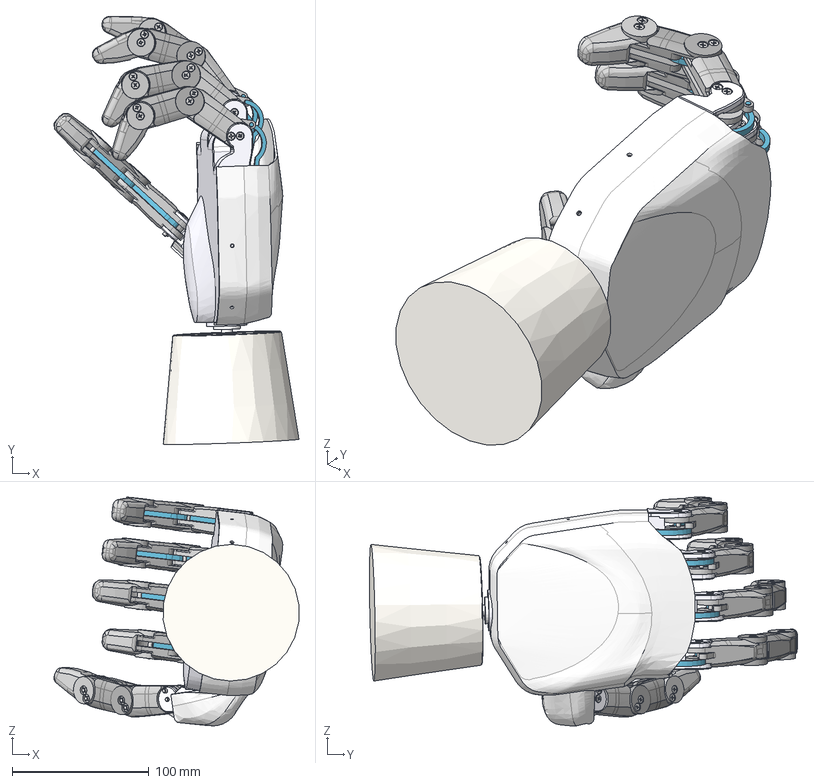
[picture p70: CAD file, 2026-10-15]
3d/moãinteira/PROTO ASSEMBLY FINAL 2.stp
179.2 x 313.2 x 167.4 mm
HAND BASE PROTO VER 2
middle cover x 5
shaft x 5
shaft^gear_sub1 x 5
gear_sub2 x 5
pcb x 5
wires1^SERVO x 5
DC Motor as part x 5
Rotor scaled x 5
gear_sub3 x 5
gear5 x 5
part 3 bottom x 5
Finger tip x 5
Connection Long test x 5
Connection Short x 5
Finger segment 1 TESTING FR x 5
Finger segment 2 TESTING FR x 5
AS 1427 - M3 x 20 x 30
Ring Rod
Index Rod
Pinkie Rod x 2
pls help
DS3225MG Servo 25Kg 4.8-6.8V B
DS3225MG Servo 25Kg 4.8-6.8V A
DS3225MG Servo 25Kg 4.8-6.8V C
disco_servo
cono
TOP COVER PROTO VER2
