Jotasquimsdb/TCC-Caua-e-Joaquim/3d/Nova pasta/robotic-hand/Servo/gear_sub2.SLDASM

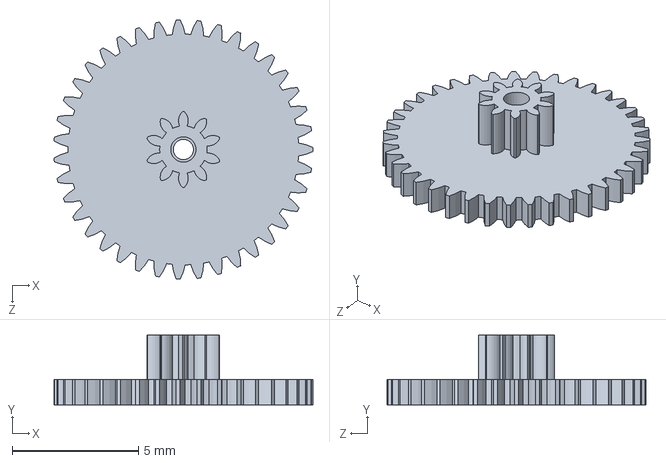
[picture p71: CAD file, 2026-10-15]
3d/Nova pasta/robotic-hand/Servo/gear_sub2.SLDASM
10.2 x 2.75 x 10.2 mm
spur gear_iso x 2
