Jotasquimsdb/TCC-Caua-e-Joaquim/3d/Nova pasta/robotic-hand/Servo/SERVO.SLDASM

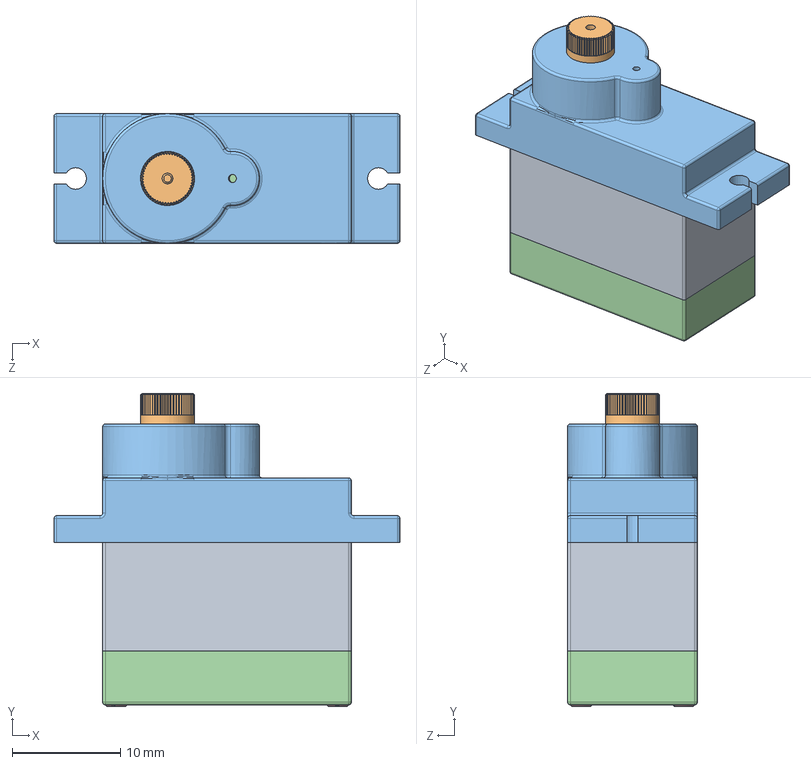
[picture p72: CAD file, 2026-10-15]
3d/Nova pasta/robotic-hand/Servo/SERVO.SLDASM
32.0 x 29.0 x 12.0 mm
middle cover
shaft
shaft^gear_sub1
spur gear_iso x 6
pcb
DC Motor as part
Rotor scaled
spur gear_am
gear5
part 3 bottom
