Jotasquimsdb/TCC-Caua-e-Joaquim/3d/Nova pasta/robotic-hand/Servo/gear_sub3.SLDASM

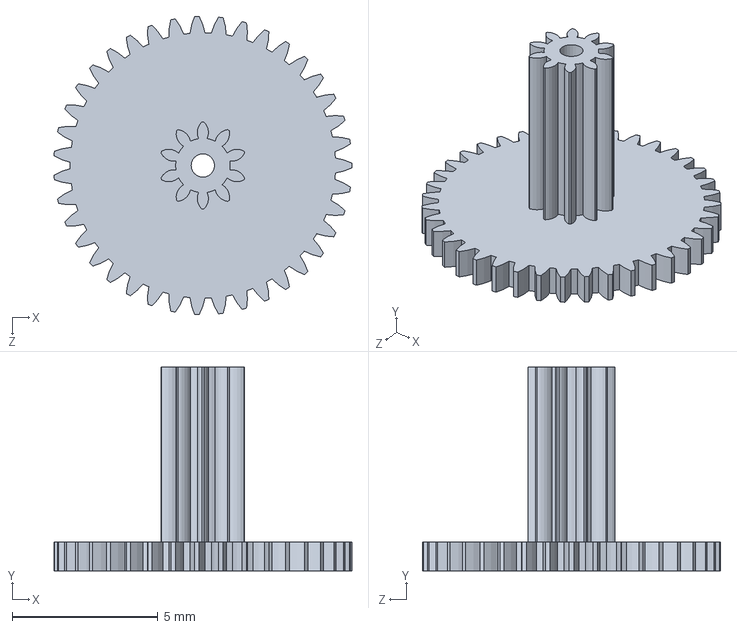
[picture p73: CAD file, 2026-10-15]
3d/Nova pasta/robotic-hand/Servo/gear_sub3.SLDASM
10.2 x 7.00 x 10.2 mm
spur gear_iso x 2
