Jotasquimsdb/TCC-Caua-e-Joaquim/3d/Nova pasta/robotic-hand/PROTO ASSEMBLY FINAL.SLDASM

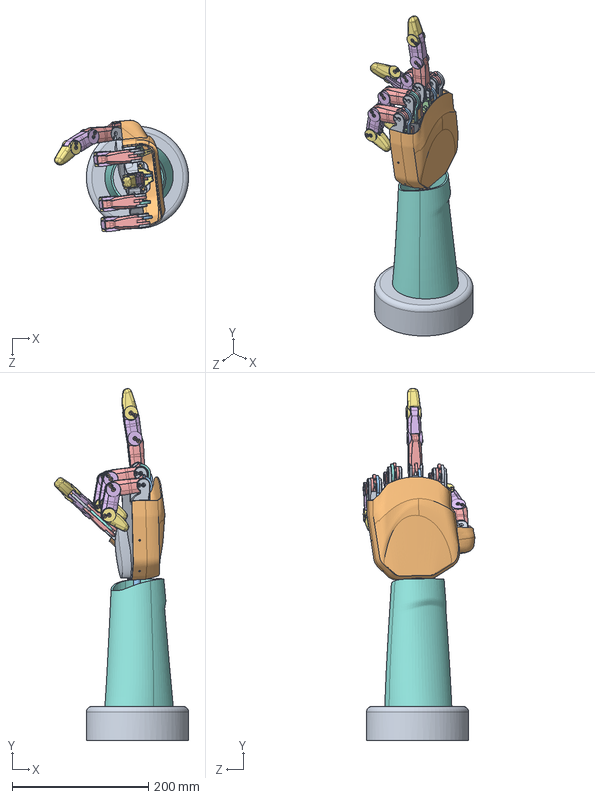
[picture p74: CAD file, 2026-10-15]
3d/Nova pasta/robotic-hand/PROTO ASSEMBLY FINAL.SLDASM
196.9 x 516.5 x 163.7 mm
HAND BASE PROTO VER 2
middle cover x 5
shaft x 5
shaft^gear_sub1 x 5
spur gear_iso x 30
pcb x 5
DC Motor as part x 5
Rotor scaled x 5
spur gear_am x 5
gear5 x 5
part 3 bottom x 5
Finger tip x 5
Connection Long test x 5
Connection Short x 5
flat head screw_am x 20
prevailing torque hex nut_am x 15
hex nut style 2_am x 5
Finger segment 1 TESTING FR x 5
Finger segment 2 TESTING FR x 5
Ring Rod
Index Rod
TOP COVER PROTO VER2
Pinkie Rod x 2
pls help
Step Motor 28BYJ-48
Arm cover
Base
Wrist bone long
Wrist bone short
radial ball bearing_68_am
hs-422_sws
