Jotasquimsdb/TCC-Caua-e-Joaquim/3d/arquivos stl/dedo stl/segmentododedo2.STL

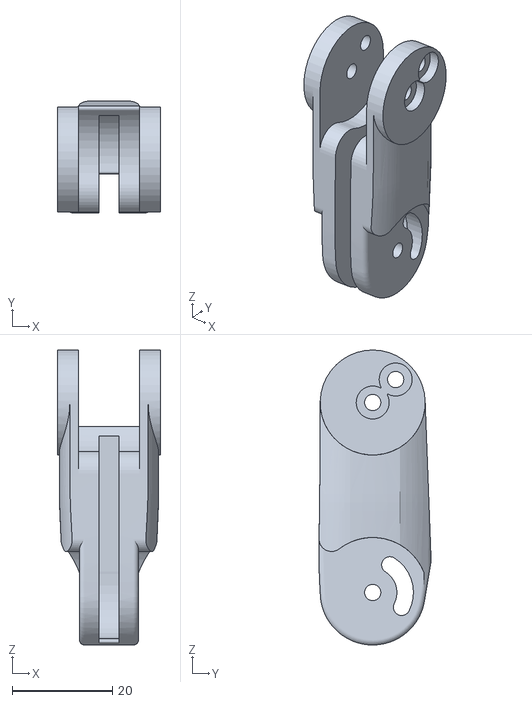
[picture p75: CAD file, 2026-10-15]
3d/arquivos stl/dedo stl/segmentododedo2.STL
20.5 x 22.4 x 59.0
