Jotasquimsdb/TCC-Caua-e-Joaquim/3d/arquivos stl/ossos/ossocurto.STL

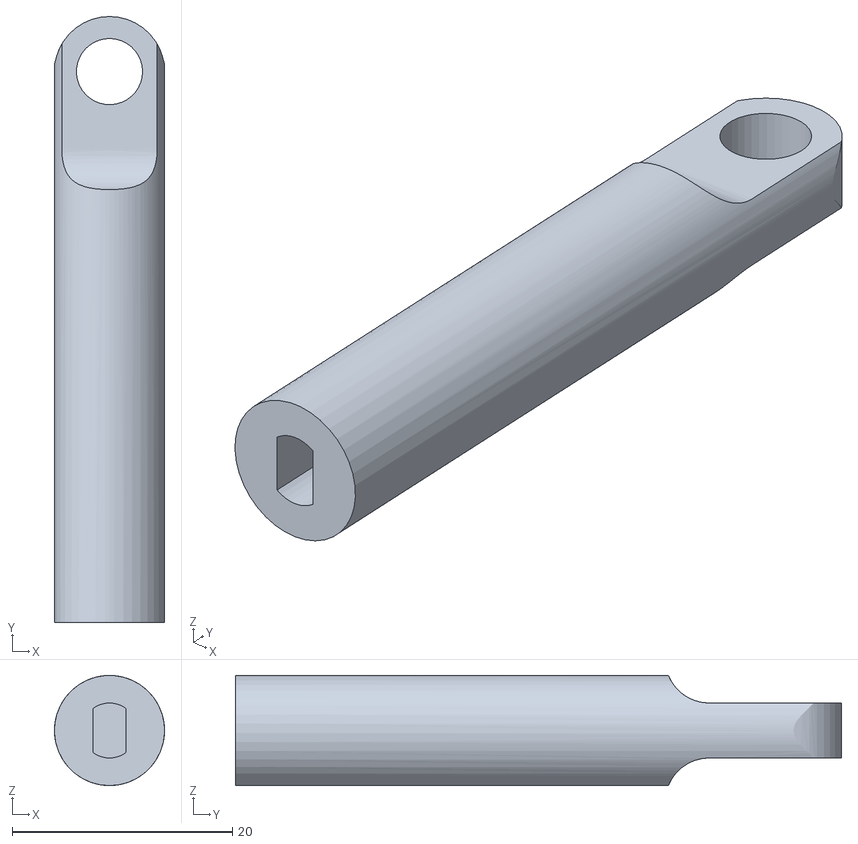
[picture p76: CAD file, 2026-10-15]
3d/arquivos stl/ossos/ossocurto.STL
10.0 x 55.0 x 10.0
