Jotasquimsdb/TCC-Caua-e-Joaquim/3d/arquivos stl/partes maiores/palma.STL

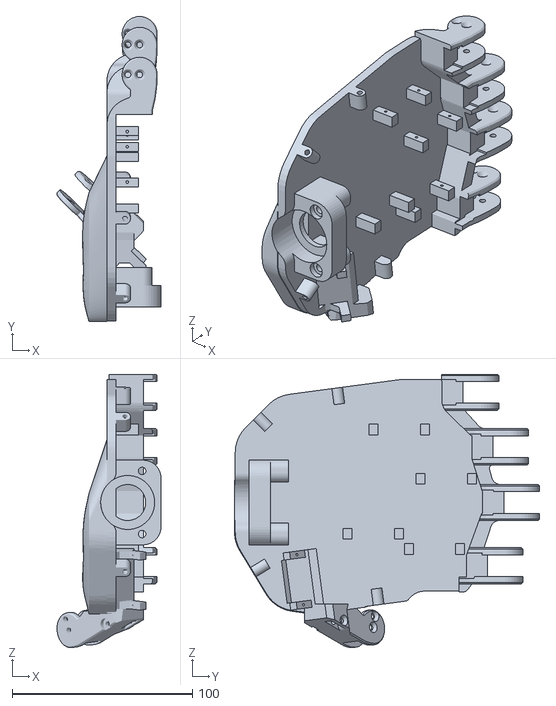
[picture p77: CAD file, 2026-10-15]
3d/arquivos stl/partes maiores/palma.STL
57.7 x 169.2 x 151.7
