Jotasquimsdb/TCC-Caua-e-Joaquim/3d/arquivos stl/ring/juntamindin.STL

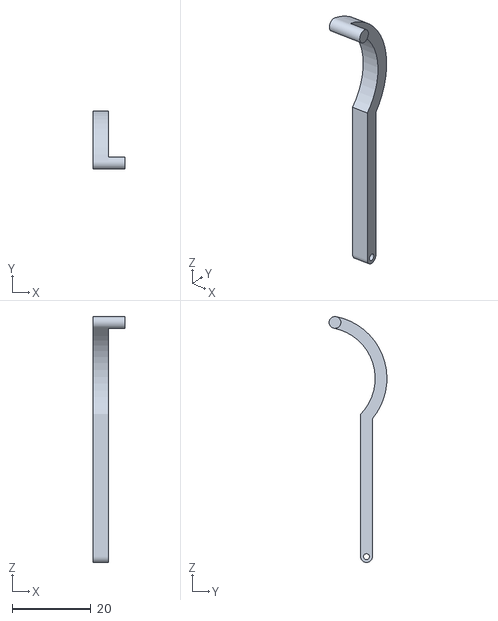
[picture p78: CAD file, 2026-10-15]
3d/arquivos stl/ring/juntamindin.STL
8.20 x 14.7 x 62.5
