Jotasquimsdb/TCC-Caua-e-Joaquim/3d/Nova pasta/robotic-hand/arquivos stl/dedo stl/pontadodedo.STL

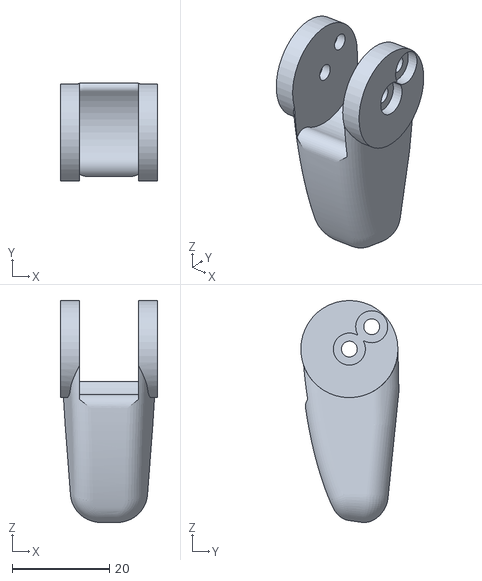
[picture p79: CAD file, 2026-10-15]
3d/Nova pasta/robotic-hand/arquivos stl/dedo stl/pontadodedo.STL
20.0 x 20.3 x 45.7
