Jotasquimsdb/TCC-Caua-e-Joaquim/3d/Nova pasta/robotic-hand/arquivos stl/partes maiores/antebraço.STL

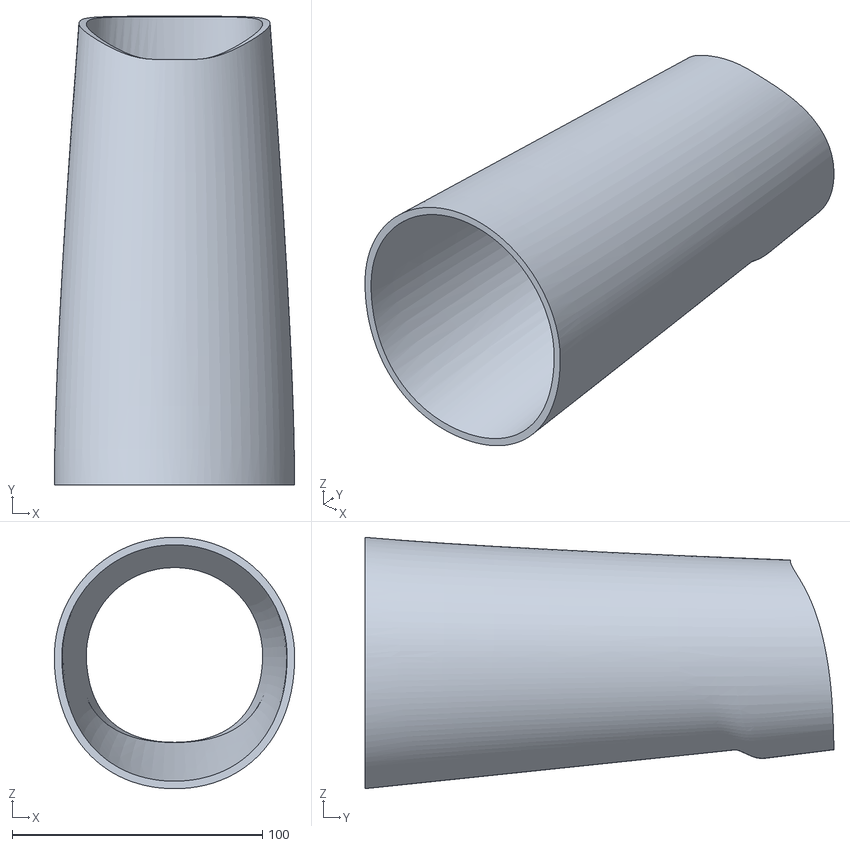
[picture p80: CAD file, 2026-10-15]
3d/Nova pasta/robotic-hand/arquivos stl/partes maiores/antebraço.STL
96.0 x 187.4 x 100.4
