Jotasquimsdb/TCC-Caua-e-Joaquim/3d/Nova pasta/robotic-hand/arquivos stl/ring/conexãodedão.STL

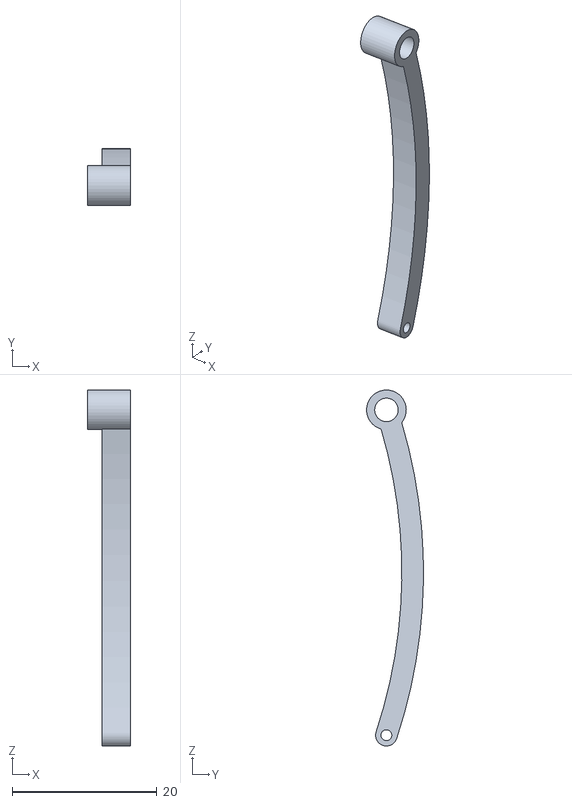
[picture p81: CAD file, 2026-10-15]
3d/Nova pasta/robotic-hand/arquivos stl/ring/conexãodedão.STL
6.00 x 7.87 x 49.2
