Jotasquimsdb/TCC-Caua-e-Joaquim/3d/Nova pasta/robotic-hand/Finger 3/Finger segment 1 TESTING FR.SLDPRT

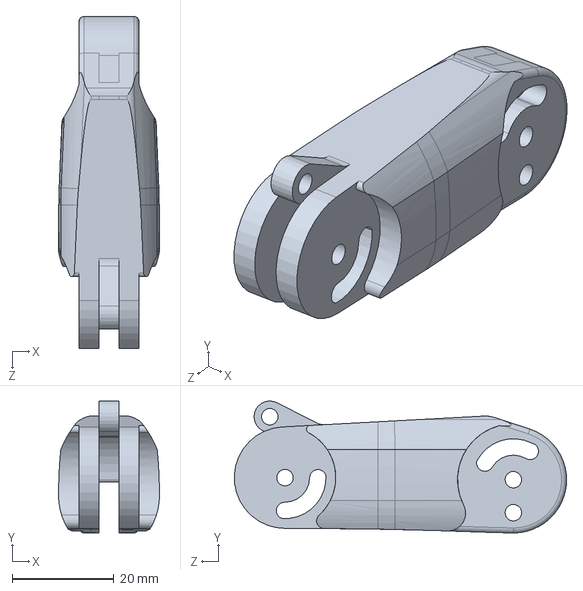
[picture p82: CAD file, 2026-10-15]
3d/Nova pasta/robotic-hand/Finger 3/Finger segment 1 TESTING FR.SLDPRT
19.8 x 26.0 x 65.5 mm
