Jotasquimsdb/TCC-Caua-e-Joaquim/3d/Nova pasta/robotic-hand/Servo/DC Motor/DC Motor as part.SLDPRT

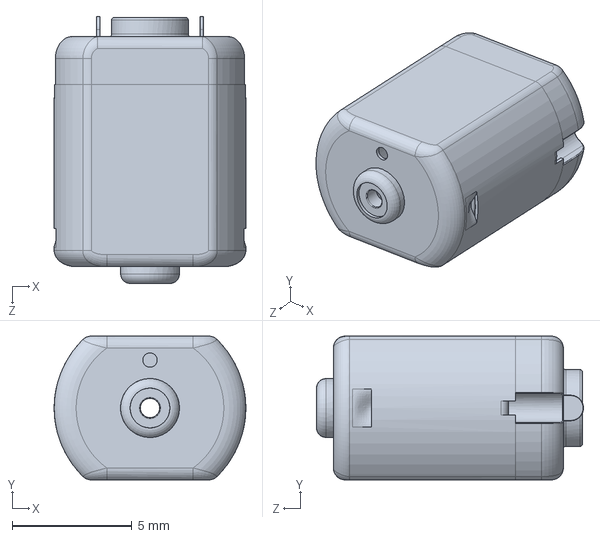
[picture p83: CAD file, 2026-10-15]
3d/Nova pasta/robotic-hand/Servo/DC Motor/DC Motor as part.SLDPRT
8.00 x 6.00 x 11.1 mm
