Jotasquimsdb/TCC-Caua-e-Joaquim/3d/Nova pasta/robotic-hand/Servo/part 3 bottom.SLDPRT

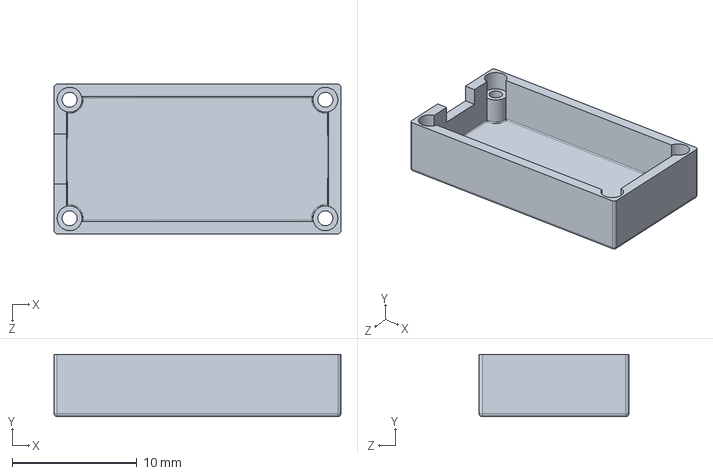
[picture p84: CAD file, 2026-10-15]
3d/Nova pasta/robotic-hand/Servo/part 3 bottom.SLDPRT
23.0 x 5.00 x 12.0 mm
