Jotasquimsdb/TCC-Caua-e-Joaquim/3d/Nova pasta/robotic-hand/Wrist bone long.SLDPRT

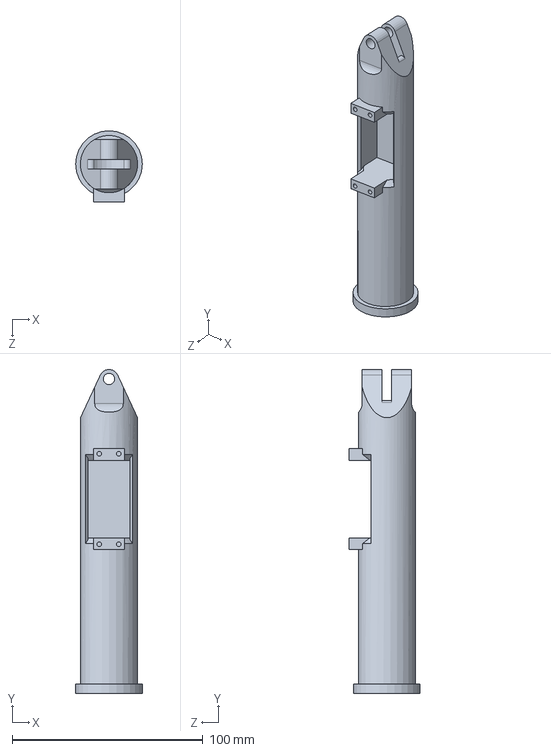
[picture p85: CAD file, 2026-10-15]
3d/Nova pasta/robotic-hand/Wrist bone long.SLDPRT
35.0 x 170.0 x 37.5 mm
