Jotasquimsdb/TCC-Caua-e-Joaquim/3d/suporte/Peça suporte tcc.SLDPRT

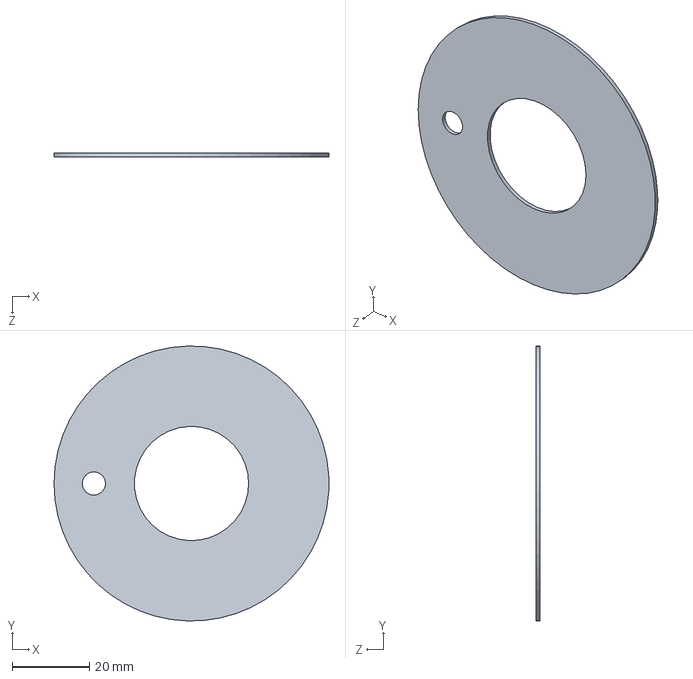
[picture p86: CAD file, 2026-10-15]
3d/suporte/Peça suporte tcc.SLDPRT
71.0 x 71.0 x 1.00 mm
