Jotasquimsdb/TCC-Caua-e-Joaquim/3d/arquivos stl/dedo stl/conectardedolongo.STL

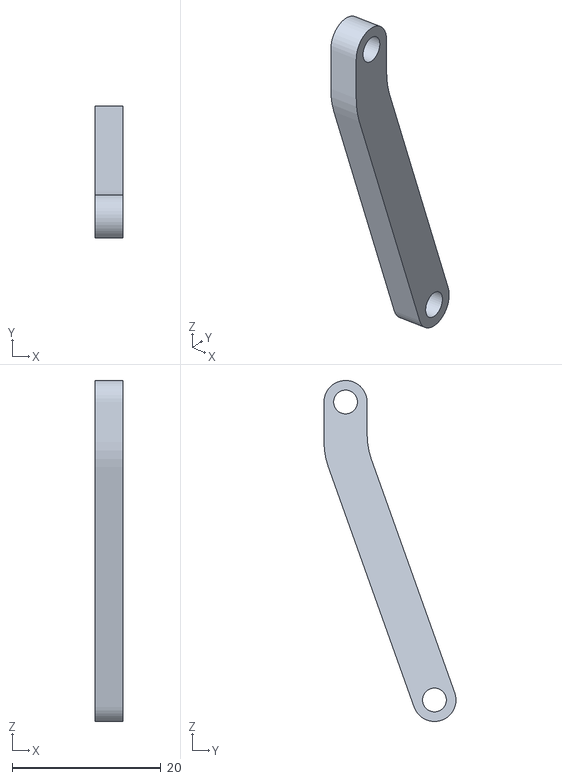
[picture p87: CAD file, 2026-10-15]
3d/arquivos stl/dedo stl/conectardedolongo.STL
3.80 x 17.7 x 45.8
