Jotasquimsdb/TCC-Caua-e-Joaquim/3d/arquivos stl/ring/juntadedão.STL

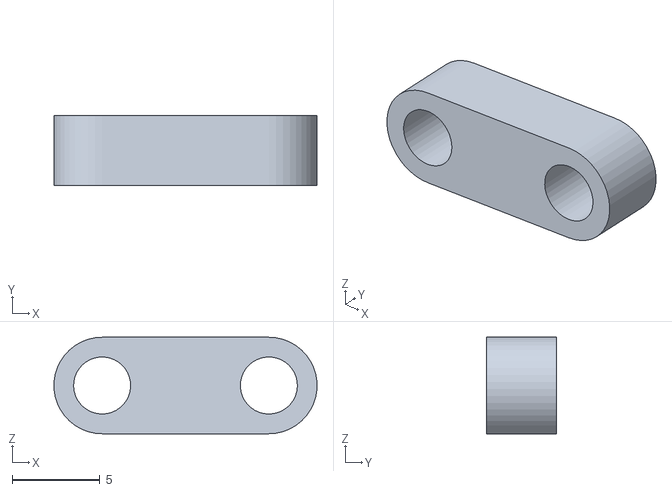
[picture p88: CAD file, 2026-10-15]
3d/arquivos stl/ring/juntadedão.STL
15.0 x 4.00 x 5.50
