Jotasquimsdb/TCC-Caua-e-Joaquim/3d/Nova pasta/robotic-hand/arquivos stl/partes maiores/Base.STL

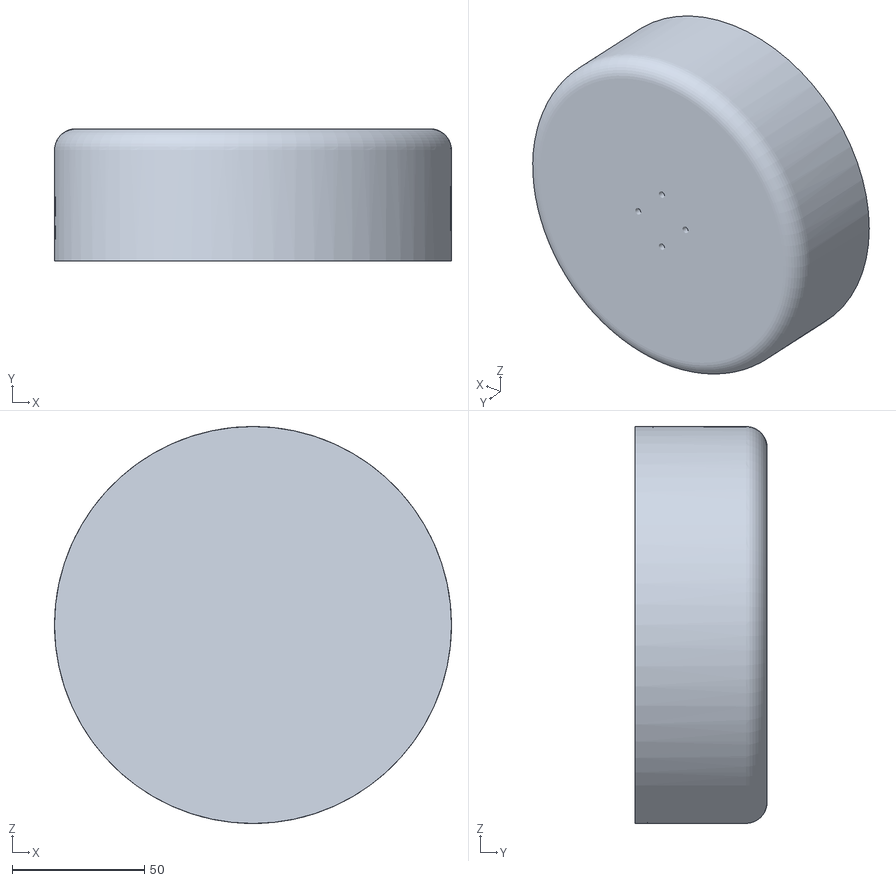
[picture p89: CAD file, 2026-10-15]
3d/Nova pasta/robotic-hand/arquivos stl/partes maiores/Base.STL
150.0 x 50.0 x 150.0
