Jotasquimsdb/TCC-Caua-e-Joaquim/3d/Nova pasta/robotic-hand/arquivos stl/ring/juntaindicador.STL

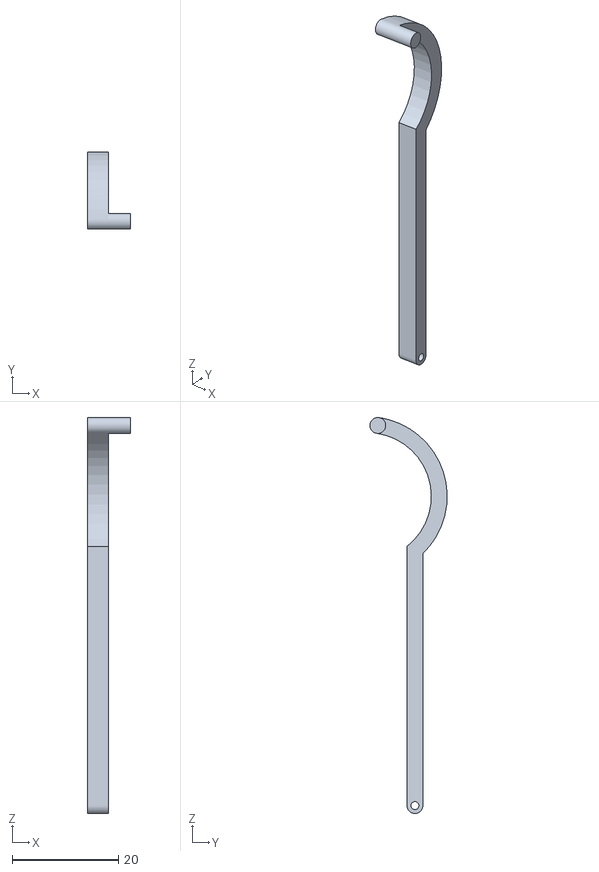
[picture p90: CAD file, 2026-10-15]
3d/Nova pasta/robotic-hand/arquivos stl/ring/juntaindicador.STL
8.20 x 14.6 x 74.7
