Jotasquimsdb/TCC-Caua-e-Joaquim/3d/Nova pasta/robotic-hand/Servo/shaft.SLDPRT

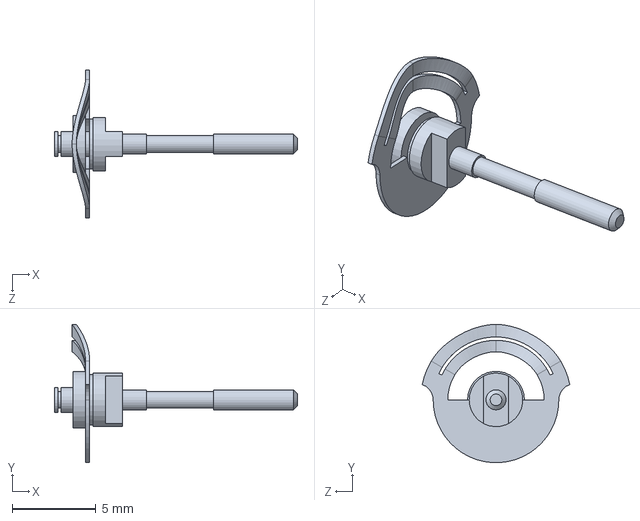
[picture p91: CAD file, 2026-10-15]
3d/Nova pasta/robotic-hand/Servo/shaft.SLDPRT
14.5 x 8.24 x 8.81 mm
