Jotasquimsdb/TCC-Caua-e-Joaquim/3d/arquivos stl/dedo stl/conectardedocurto.STL

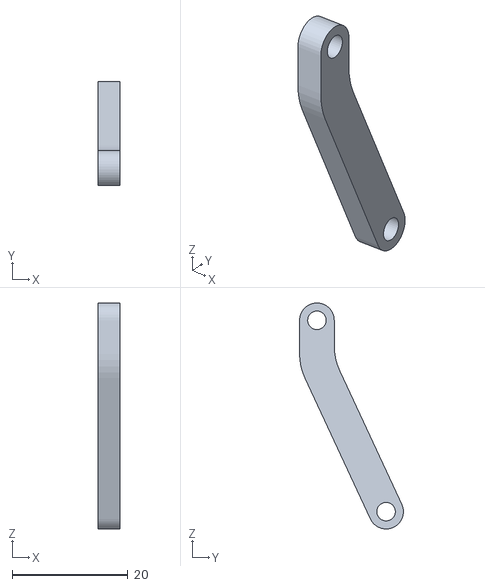
[picture p92: CAD file, 2026-10-15]
3d/arquivos stl/dedo stl/conectardedocurto.STL
3.80 x 17.9 x 39.0
