Jotasquimsdb/TCC-Caua-e-Joaquim/3d/arquivos stl/ring/juntaanelar.STL

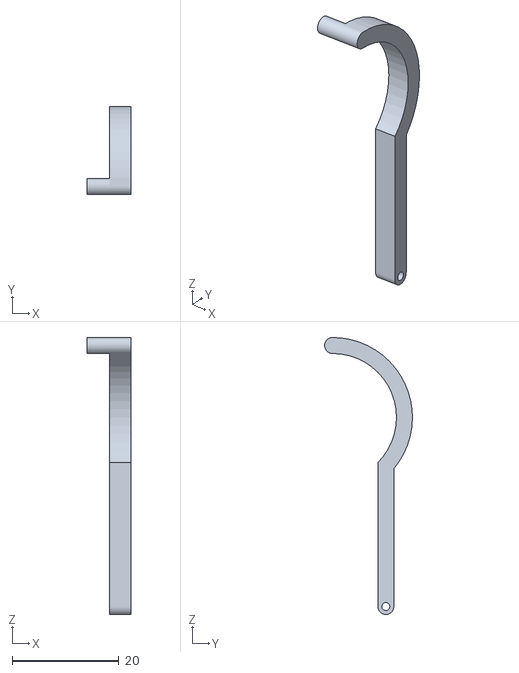
[picture p93: CAD file, 2026-10-15]
3d/arquivos stl/ring/juntaanelar.STL
8.20 x 16.5 x 52.0
