Jotasquimsdb/TCC-Caua-e-Joaquim/3d/Nova pasta/robotic-hand/arquivos stl/partes maiores/parte de tras da mão.STL

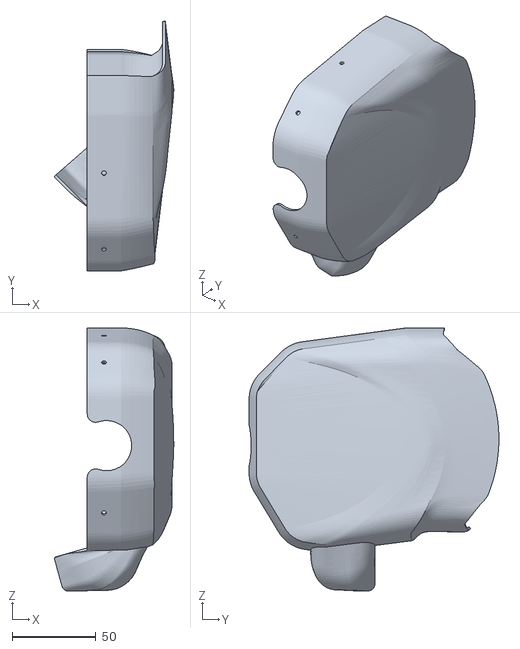
[picture p94: CAD file, 2026-10-15]
3d/Nova pasta/robotic-hand/arquivos stl/partes maiores/parte de tras da mão.STL
71.4 x 149.2 x 157.1
