Jotasquimsdb/TCC-Caua-e-Joaquim/3d/Nova pasta/robotic-hand/arquivos stl/ring/conexãodedão1.STL

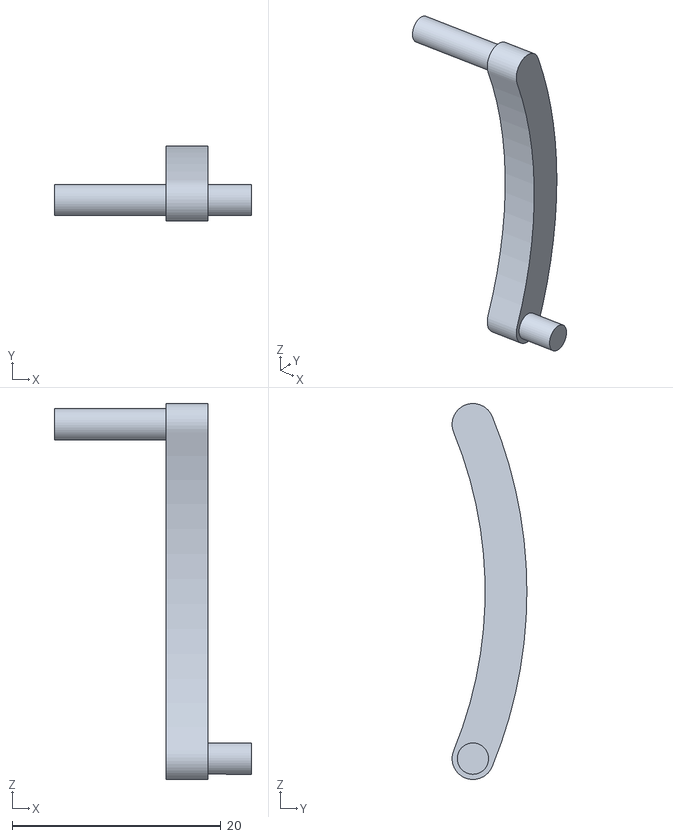
[picture p95: CAD file, 2026-10-15]
3d/Nova pasta/robotic-hand/arquivos stl/ring/conexãodedão1.STL
18.9 x 7.16 x 36.0
