Jotasquimsdb/TCC-Caua-e-Joaquim/3d/Nova pasta/robotic-hand/Servo/gear5.SLDPRT

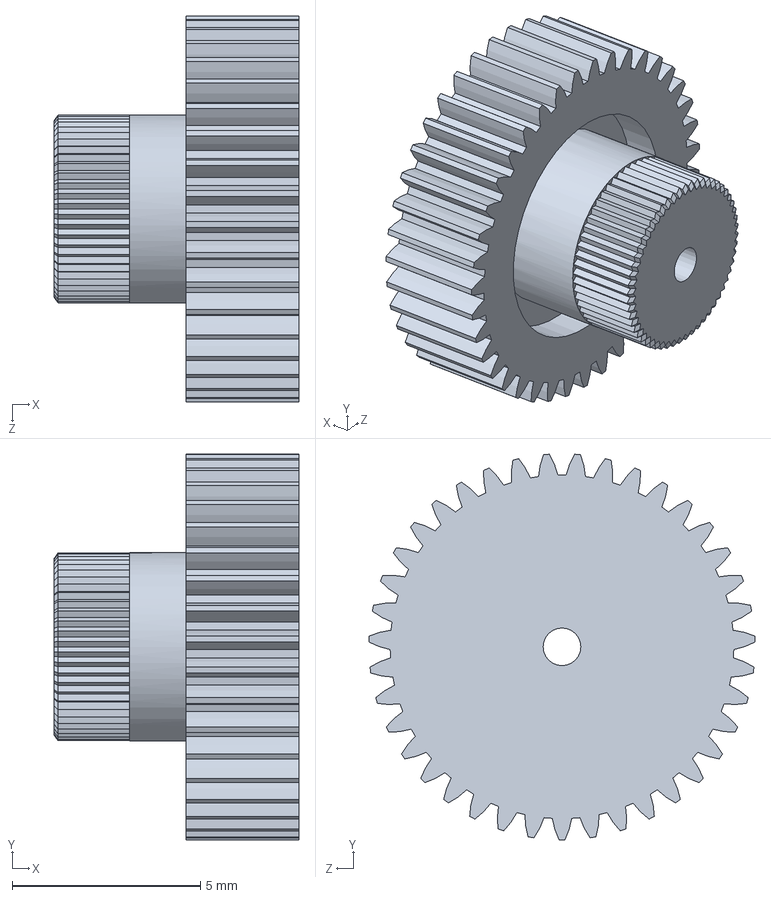
[picture p96: CAD file, 2026-10-15]
3d/Nova pasta/robotic-hand/Servo/gear5.SLDPRT
6.50 x 10.2 x 10.2 mm
