Jotasquimsdb/TCC-Caua-e-Joaquim/3d/Nova pasta/robotic-hand/Pinkie Rod.SLDPRT

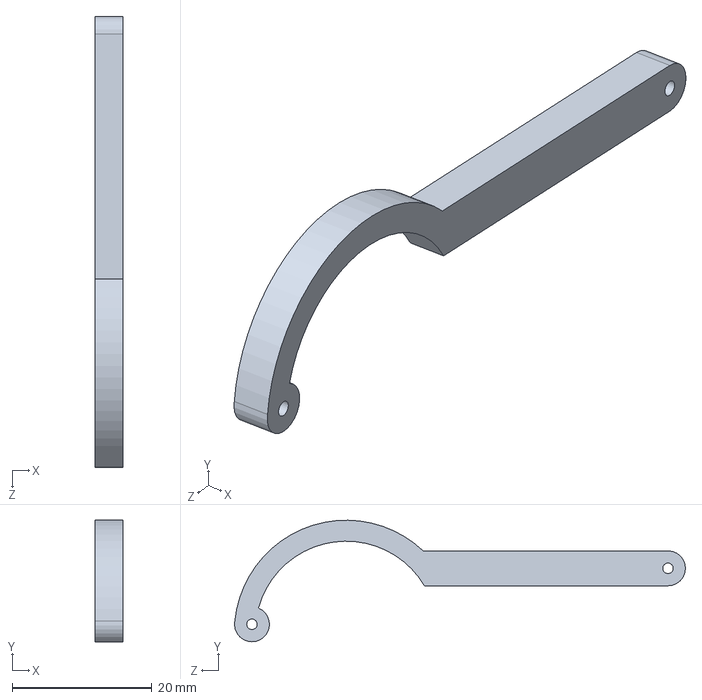
[picture p97: CAD file, 2026-10-15]
3d/Nova pasta/robotic-hand/Pinkie Rod.SLDPRT
4.00 x 17.4 x 64.5 mm
