Jotasquimsdb/TCC-Caua-e-Joaquim/3d/Nova pasta/robotic-hand/Servo/Rotor scaled.SLDPRT

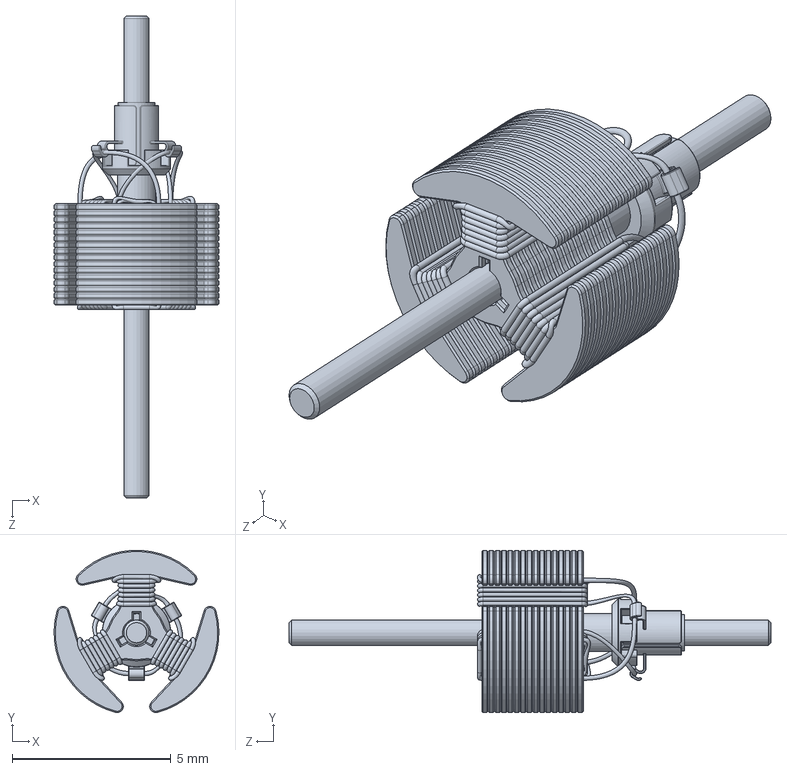
[picture p98: CAD file, 2026-10-15]
3d/Nova pasta/robotic-hand/Servo/Rotor scaled.SLDPRT
5.20 x 5.12 x 15.2 mm
