Jotasquimsdb/TCC-Caua-e-Joaquim/3d/Nova pasta/robotic-hand/hs-422_sws.SLDPRT

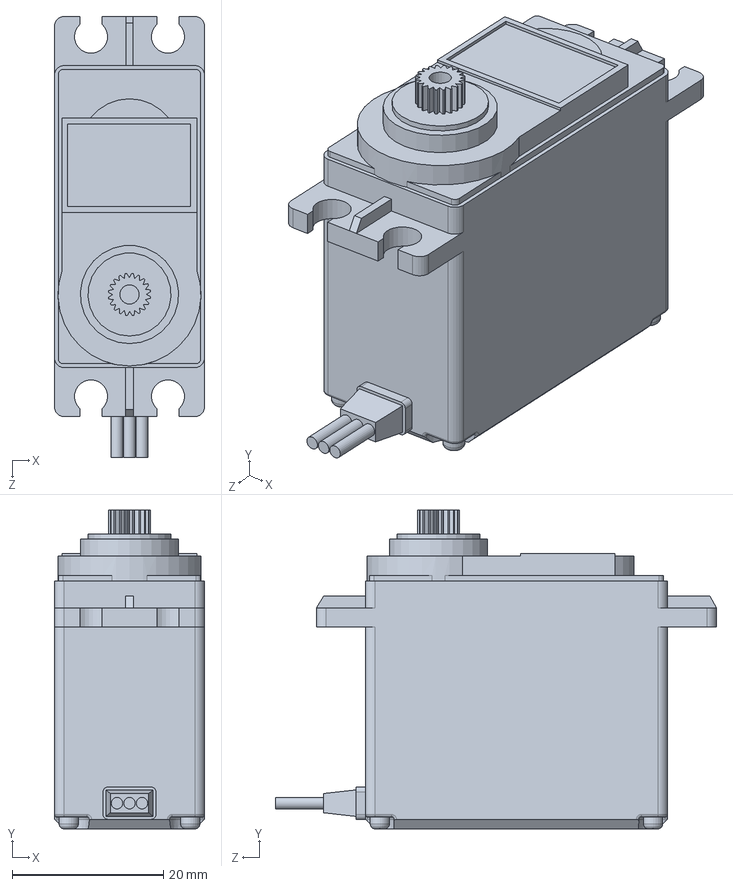
[picture p99: CAD file, 2026-10-15]
3d/Nova pasta/robotic-hand/hs-422_sws.SLDPRT
19.8 x 42.1 x 58.2 mm
