Jotasquimsdb/TCC-Caua-e-Joaquim/3d/Nova pasta/robotic-hand/Servo/Part6.SLDPRT

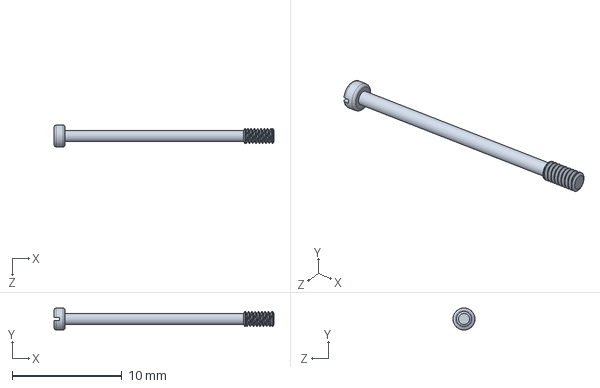
[picture p100: CAD file, 2026-10-15]
3d/Nova pasta/robotic-hand/Servo/Part6.SLDPRT
20.0 x 2.00 x 2.00 mm
