Jotasquimsdb/TCC-Caua-e-Joaquim/3d/Nova pasta/robotic-hand/Servo/middle cover.SLDPRT

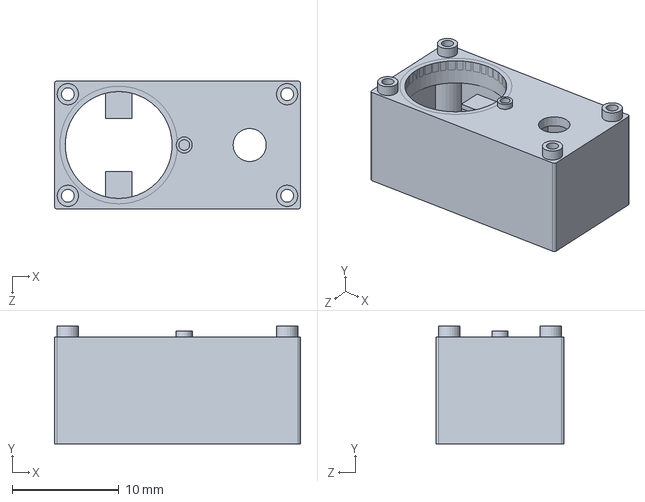
[picture p101: CAD file, 2026-10-15]
3d/Nova pasta/robotic-hand/Servo/middle cover.SLDPRT
23.0 x 11.0 x 12.0 mm
