Jotasquimsdb/TCC-Caua-e-Joaquim/3d/Nova pasta/robotic-hand/Servo/Part7-2.SLDPRT

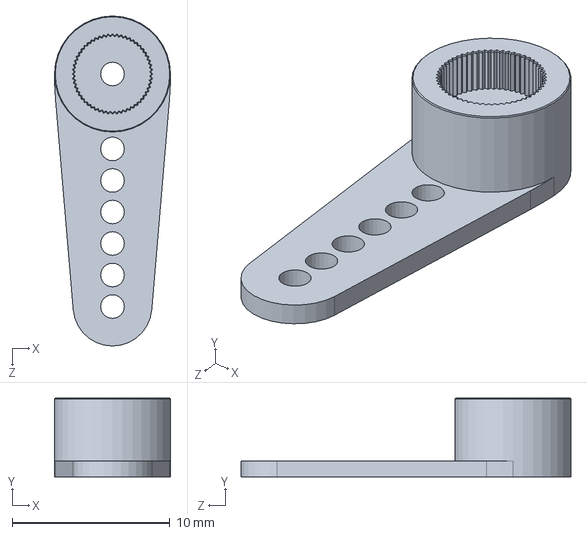
[picture p102: CAD file, 2026-10-15]
3d/Nova pasta/robotic-hand/Servo/Part7-2.SLDPRT
7.36 x 5.00 x 20.9 mm
