Jotasquimsdb/TCC-Caua-e-Joaquim/3d/Nova pasta/robotic-hand/Servo/pcb.SLDPRT

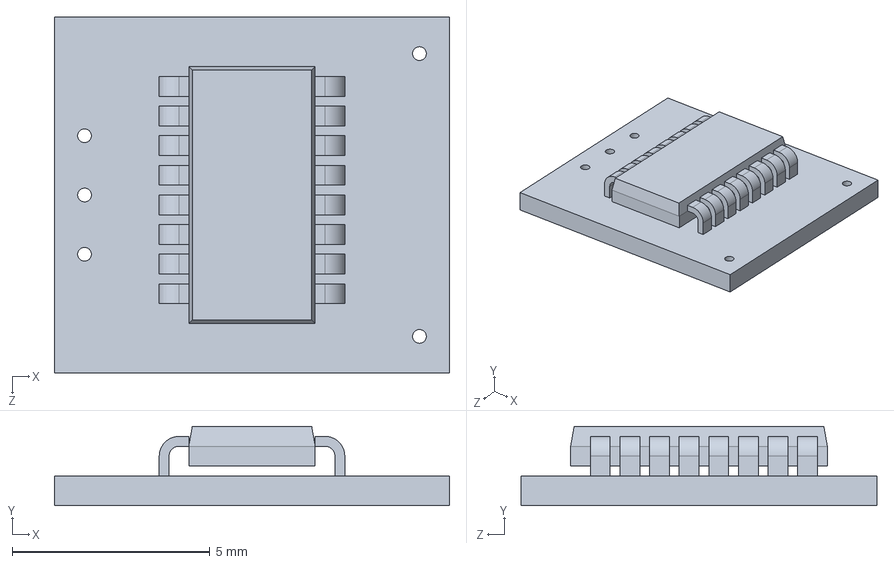
[picture p103: CAD file, 2026-10-15]
3d/Nova pasta/robotic-hand/Servo/pcb.SLDPRT
10.0 x 2.00 x 9.00 mm
