Jotasquimsdb/TCC-Caua-e-Joaquim/3d/Nova pasta/robotic-hand/Servo/Rotor.SLDPRT

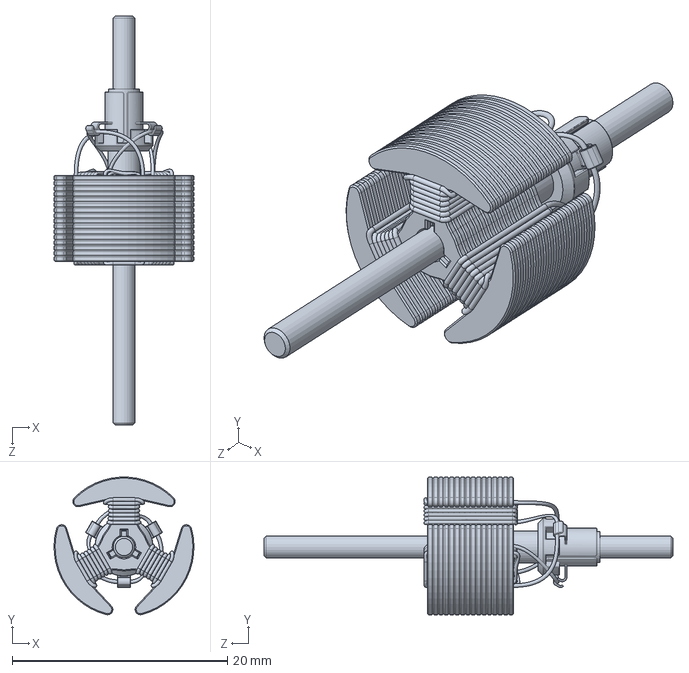
[picture p104: CAD file, 2026-10-15]
3d/Nova pasta/robotic-hand/Servo/Rotor.SLDPRT
13.0 x 12.8 x 38.0 mm
