Jotasquimsdb/TCC-Caua-e-Joaquim/3d/Nova pasta/robotic-hand/Servo/Part5.SLDPRT

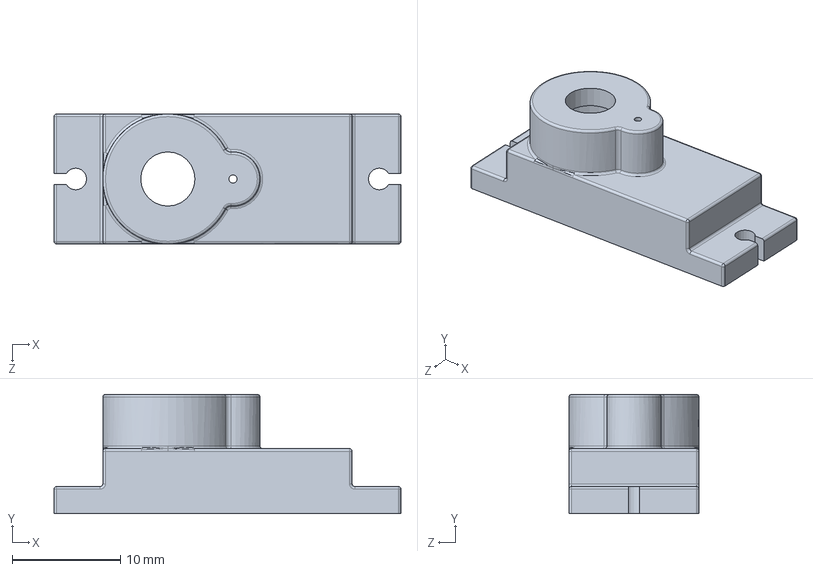
[picture p105: CAD file, 2026-10-15]
3d/Nova pasta/robotic-hand/Servo/Part5.SLDPRT
32.0 x 11.0 x 12.0 mm
