Jotasquimsdb/TCC-Caua-e-Joaquim/3d/Nova pasta/robotic-hand/Servo/part 1.SLDPRT

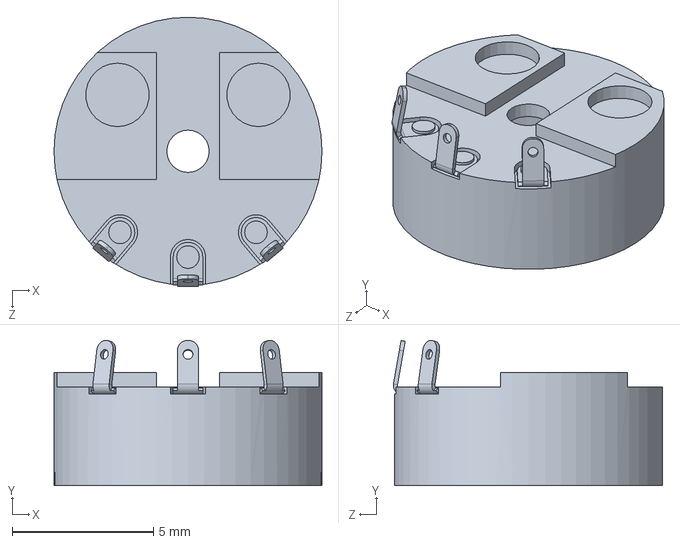
[picture p106: CAD file, 2026-10-15]
3d/Nova pasta/robotic-hand/Servo/part 1.SLDPRT
9.50 x 5.14 x 9.55 mm
