Jotasquimsdb/TCC-Caua-e-Joaquim/3d/Nova pasta/robotic-hand/Step Motor 28BYJ-48.SLDPRT

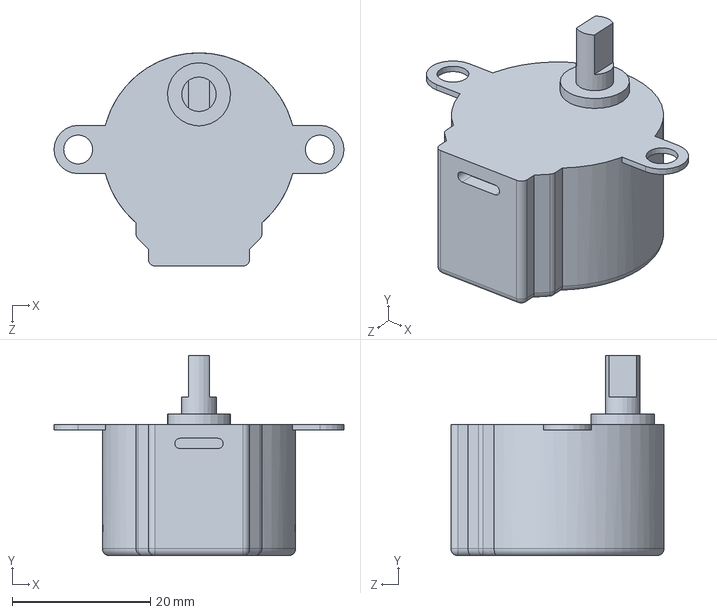
[picture p107: CAD file, 2026-10-15]
3d/Nova pasta/robotic-hand/Step Motor 28BYJ-48.SLDPRT
42.0 x 29.0 x 30.9 mm
