Jotasquimsdb/TCC-Caua-e-Joaquim/(list of files, cad)

Other CAD files:
3d/Nova pasta/robotic-hand/Servo/SERVO 2.SLDASM
3d/Nova pasta/robotic-hand/Servo/gear_sub1.SLDASM
3d/moãinteira/maointeiratccfreecadalteracoes.FCStd
3d/arquivos stl/ossos/ossolongo.STL
3d/Nova pasta/robotic-hand/pls help.SLDPRT
3d/Nova pasta/robotic-hand/Connection Long test.SLDPRT
3d/Nova pasta/robotic-hand/Finger 3/Finger segment 2 TESTING FR.SLDPRT
3d/arquivos stl/dedo stl/segmentododedo1.STL
3d/Nova pasta/robotic-hand/arquivos stl/ring/juntameio (2).STL
3d/Nova pasta/robotic-hand/Finger 3/Finger tip.SLDPRT
3d/Nova pasta/robotic-hand/Part1.SLDPRT
3d/Nova pasta/robotic-hand/HAND BASE PROTO VER 2.SLDPRT
3d/Nova pasta/robotic-hand/Arm cover.SLDPRT
3d/Nova pasta/robotic-hand/Index Rod.SLDPRT
3d/Nova pasta/robotic-hand/Part2.SLDPRT
3d/Nova pasta/robotic-hand/Base.SLDPRT
3d/Nova pasta/robotic-hand/TOP COVER PROTO VER2.SLDPRT
3d/Nova pasta/robotic-hand/Wrist bone short.SLDPRT
3d/Nova pasta/robotic-hand/Ring Rod.SLDPRT
3d/Nova pasta/robotic-hand/Connection Short.SLDPRT
3d/moãinteira/PROTO ASSEMBLY FINAL.SLDASM
3d/moãinteira/desenhotecnicomaocompleta.SLDDRW
3d/suporte/Peça suporte tcc.DXF
3d/suporte/Peça suporte tcc.SLDDRW
