Jotasquimsdb/TCC-Caua-e-Joaquim/3d/moãinteira/costamão.pdf

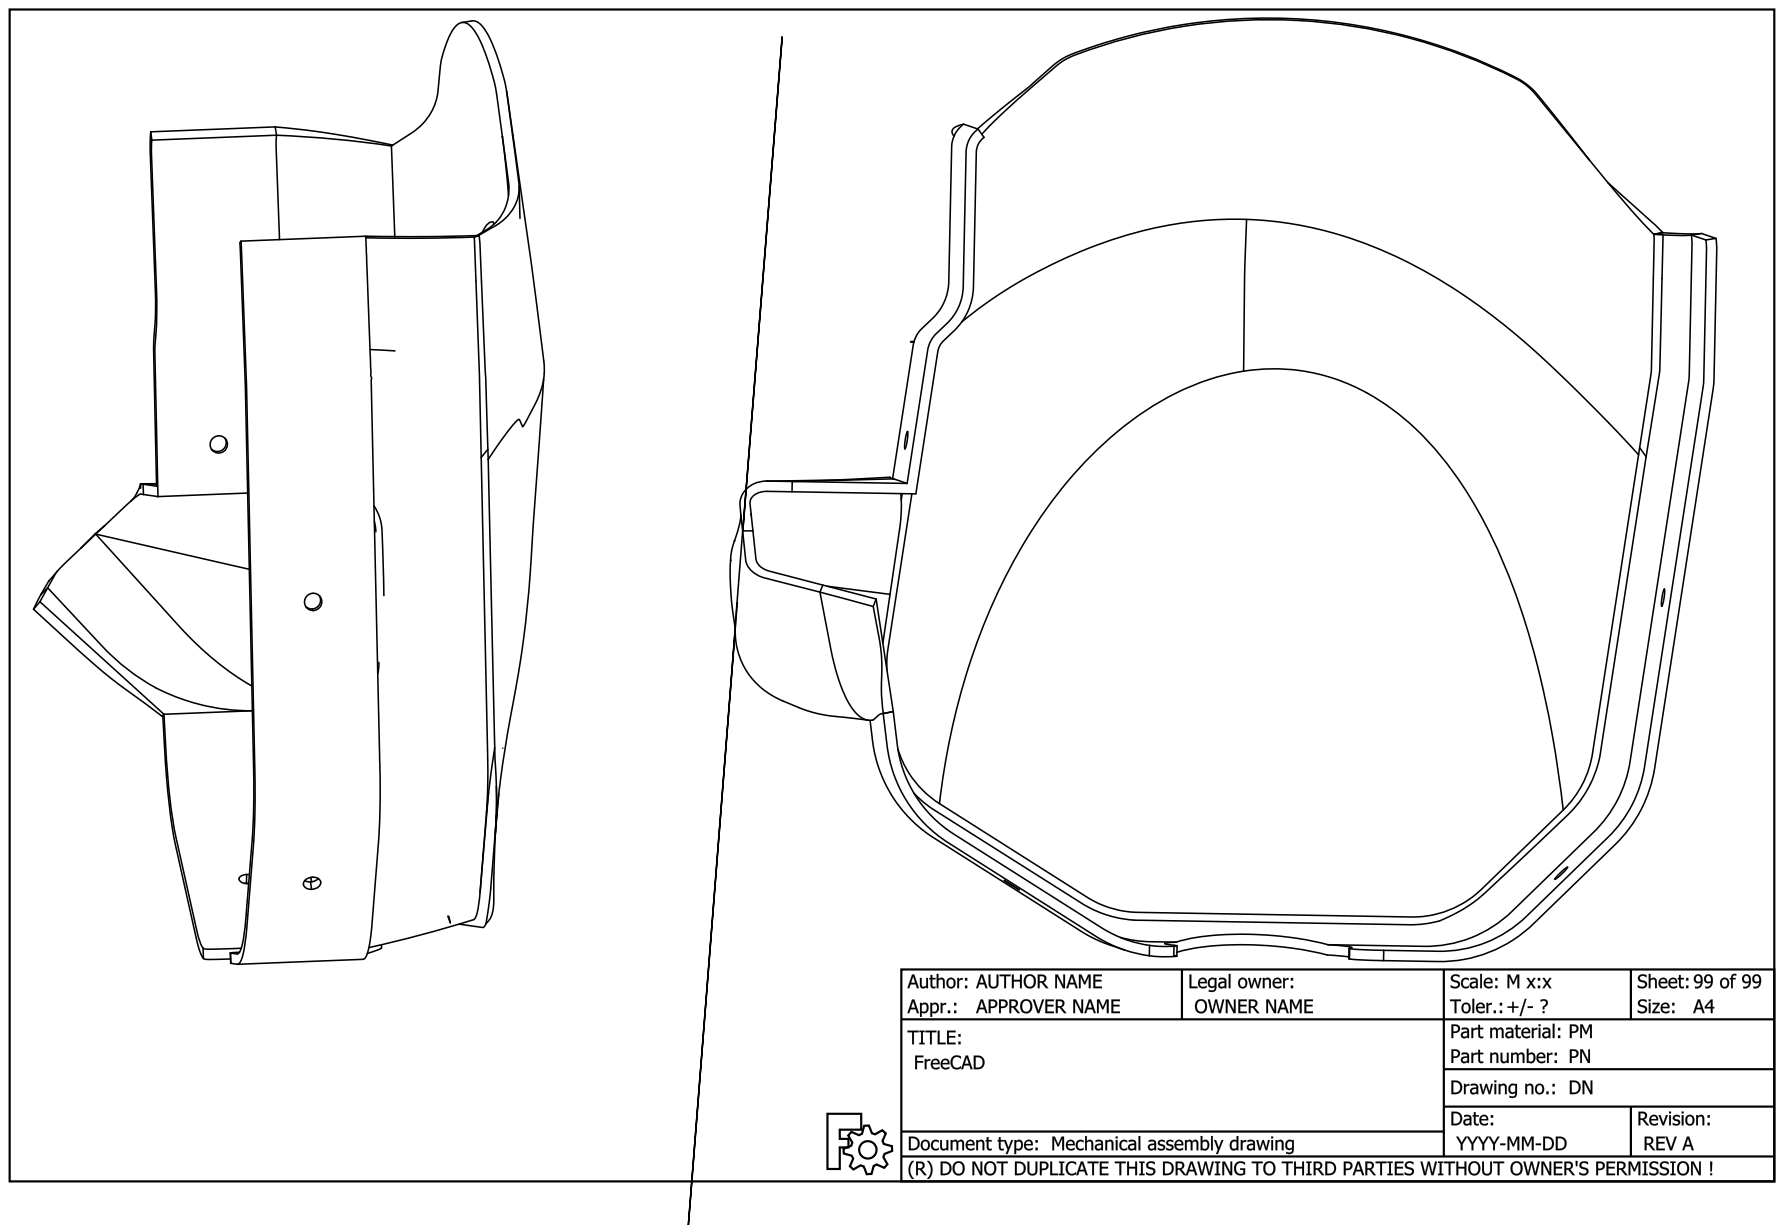
[picture p108: page 1]
