Jotasquimsdb/TCC-Caua-e-Joaquim/3d/moãinteira/dedo.pdf

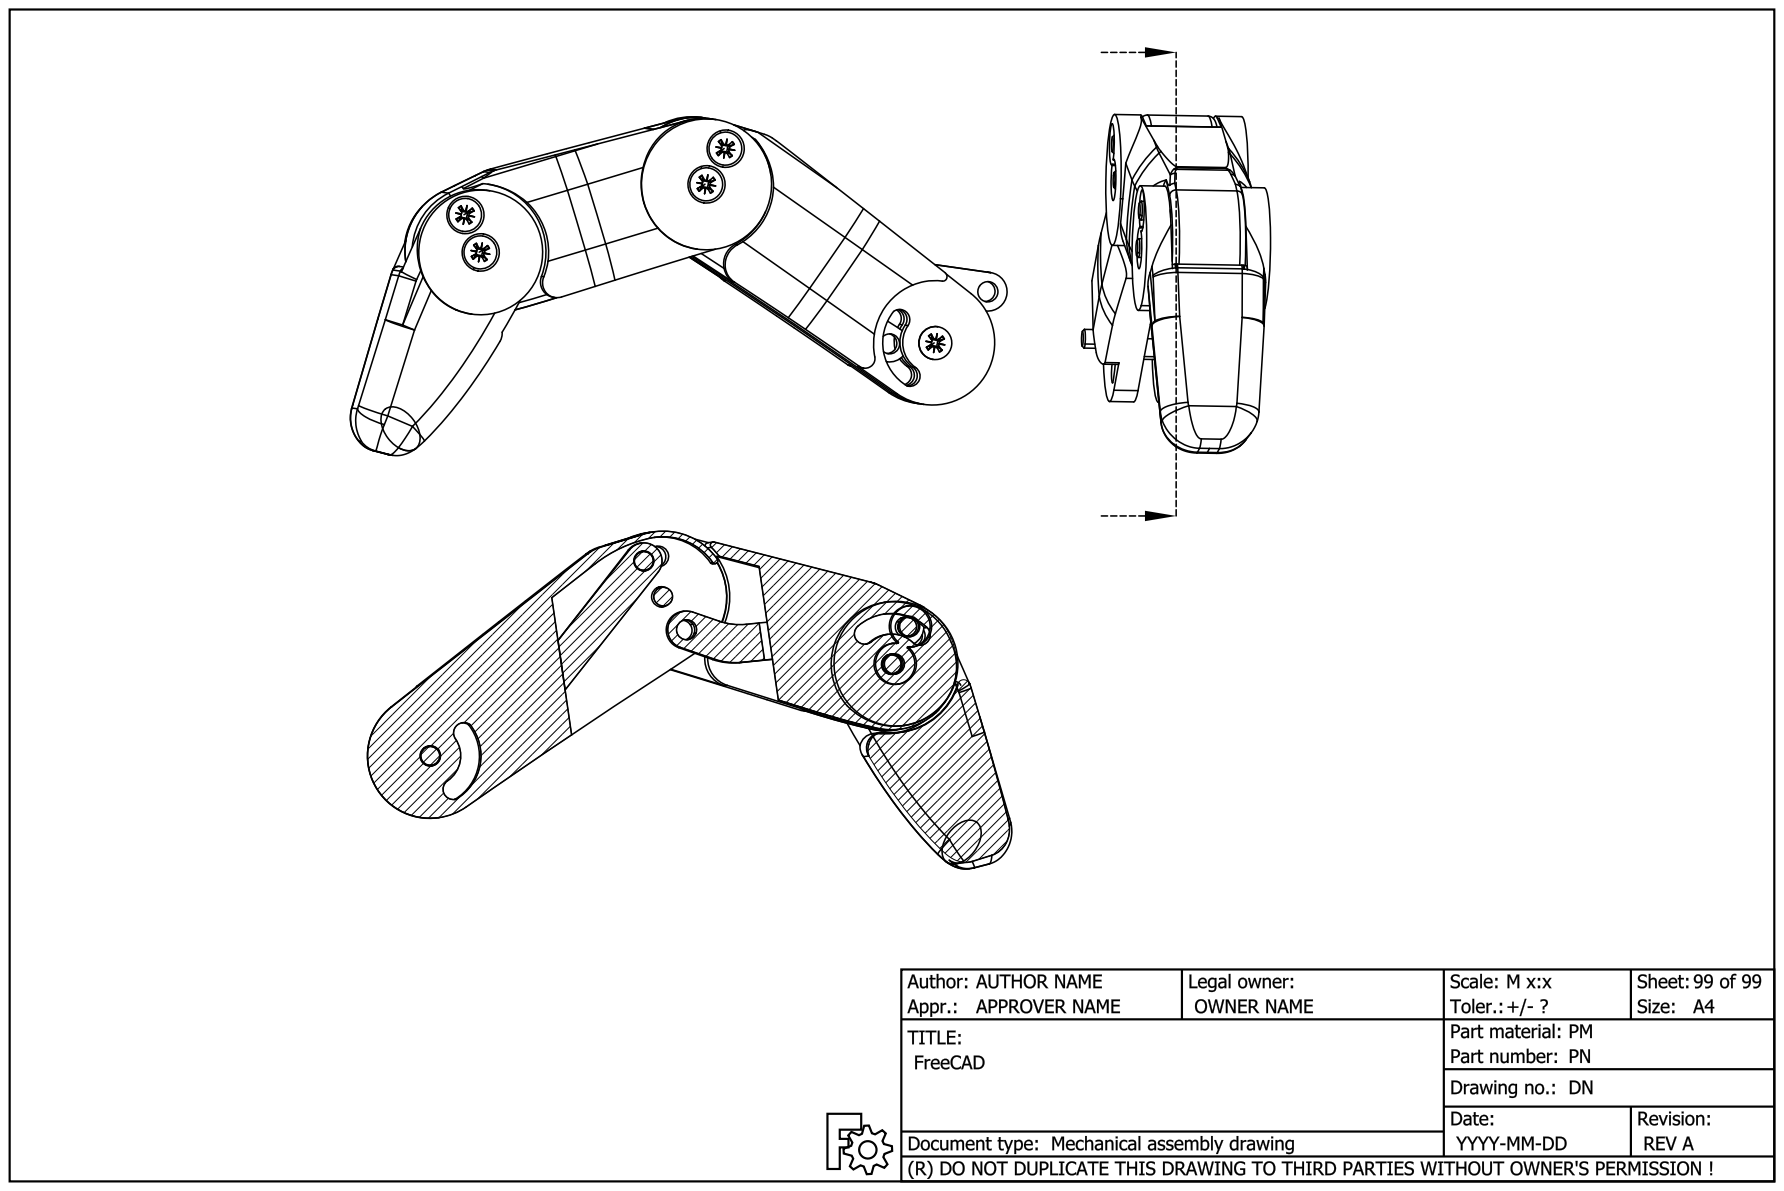
[picture p109: page 1]
