Jotasquimsdb/TCC-Caua-e-Joaquim/3d/moãinteira/palma.pdf

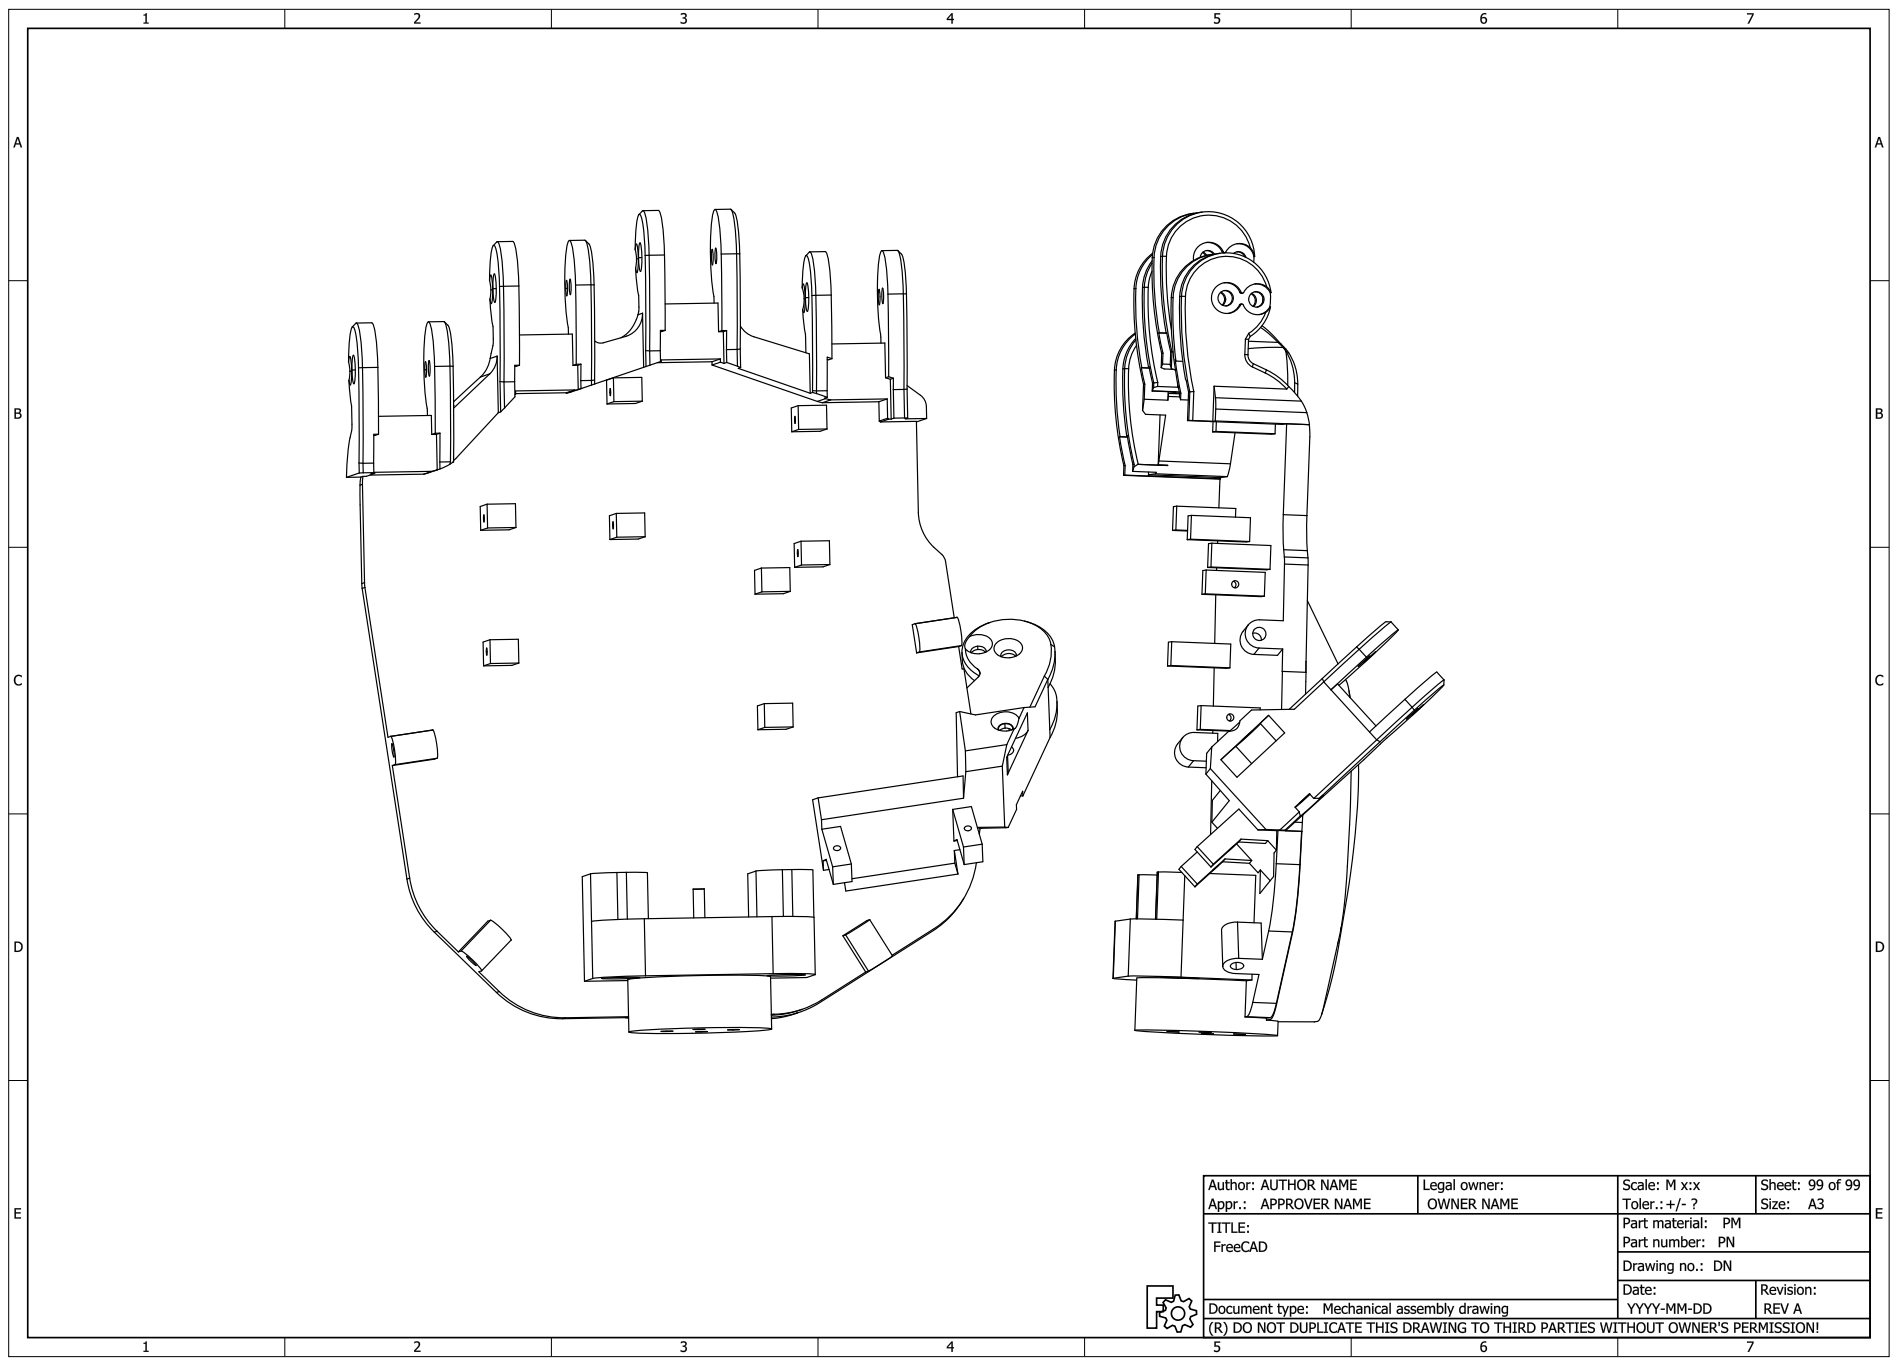
[picture p110: page 1]
