Jotasquimsdb/TCC-Caua-e-Joaquim/(list of files, drawings)

Other design files:
placa pcb/SCH_TCCTODOSEMFILTRO_2026-10-14.json
